PantsForBirds/adsbee/docs/adsbee-1090/index.md

# ADSBee 1090 Family

Receivers in the ADSBee 1090 family are built around a discrete Mode S receiver architecture with a custom RP2040 PIO-based decoder. These devices offer full-featured ground station level performance comparable to SDR-based receivers for a fraction of the power and size.

All receivers currently offered in the ADSBee 1090 family are capable of dual band reception (Mode S + UAT, including traffic and weather), and many offer network capabilities (WiFi or Ethernet).

To get an ADSBee 1090 up and running, see the [Quick Start](../getting-started/quick-start.md).

## 1090U

Dual-band Mode S and UAT receiver with USB, UART, and WiFi connectivity options.

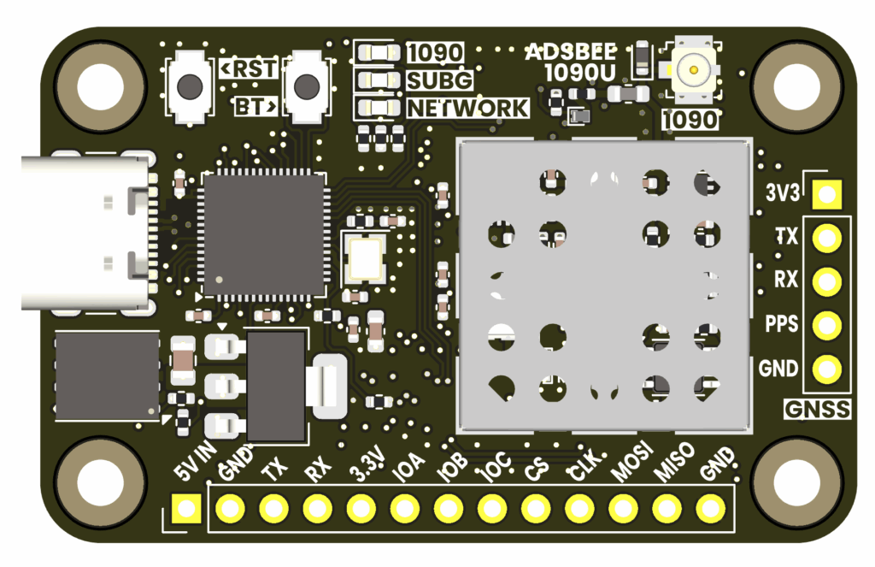
[picture p9: docs/assets/adsbee-1090/2025-06-image-1024x663.png]
ADSBee 1090U


## m1090

Single-band solder-down receiver module for OEM applications.

Dual band RX / WiFi / Ethernet functionality available with additional components.

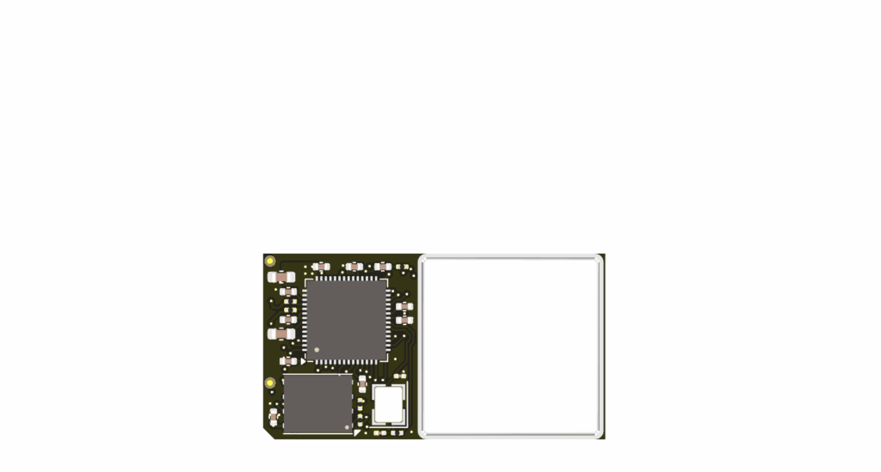
[picture p10: docs/assets/adsbee-1090/2025-06-image-2-e1749438381519-1024x549.png]
ADSBee m1090


## Winglet

Tri-band Mode S, UAT, and 2.4GHz Remote ID receiver with USB, UART, WiFi, built-in battery, illuminated ePaper screen, membrane keypad, and sensors for electronic flight bag and high performance ground station applications. See the [ADSBee Winglet page](winglet.md).

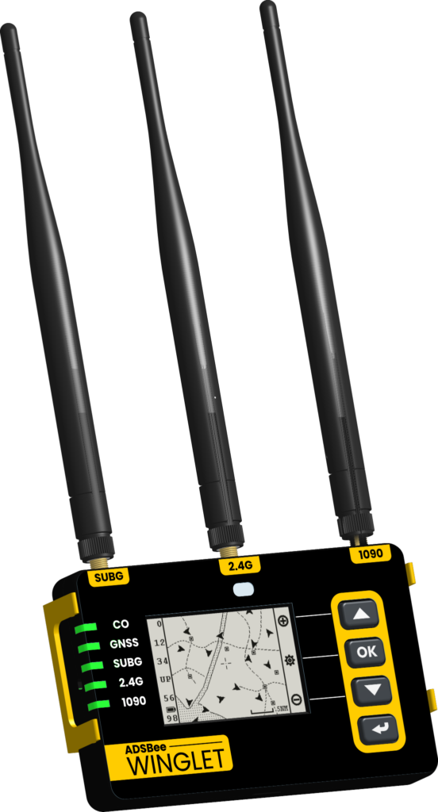
[picture p11: docs/assets/adsbee-1090/2026-07-adsbee-winglet-angle-right-552x1024.png]
ADSBee Winglet


## GS3M PoE

Dual-band Mode S and UAT industrial ground station with PoE.

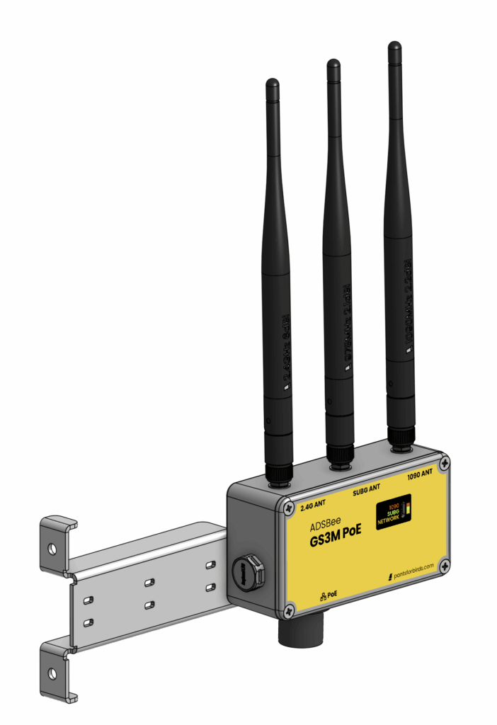
[picture p12: docs/assets/adsbee-1090/2025-09-adsbee-gs3m-poe-pic-702x1024.png]
ADSBee GS3M PoE


## Datasheet

Datasheets are available on GitHub:

- [ADSBee 1090 datasheet](https://github.com/PantsForBirds/adsbee/blob/main/word/exports/datasheet_adsbee_1090.pdf)
- [ADSBee 1090 firmware reference guide](https://github.com/PantsForBirds/adsbee/blob/main/word/exports/firmware_reference_guide_adsbee_1090.pdf)
- [ADSBee m1090 eval board datasheet](https://github.com/PantsForBirds/adsbee/blob/main/word/exports/datasheet_adsbee_m1090_eval_board.pdf)
- [ADSBee GS3M PoE datasheet](https://github.com/PantsForBirds/adsbee/blob/main/word/exports/datasheet_gs3m_poe.pdf)

## Software

- [ADSBee 1090 web console](https://github.com/PantsForBirds/adsbee/blob/main/software/adsbee_1090_console/README.md)
- [Building the firmware](https://github.com/PantsForBirds/adsbee/blob/main/firmware/README.md)
