PantsForBirds/adsbee/docs/community.md

# Community

- [Quick start documentation](getting-started/quick-start.md)
- [Join us on Discord!](https://discord.gg/KRgVT9sSVW)
- [Subscribe to the mailing list](https://groups.google.com/a/pantsforbirds.com/g/adsbee-newsletter)
- [View code on GitHub](https://github.com/PantsForBirds/adsbee)

## Gallery

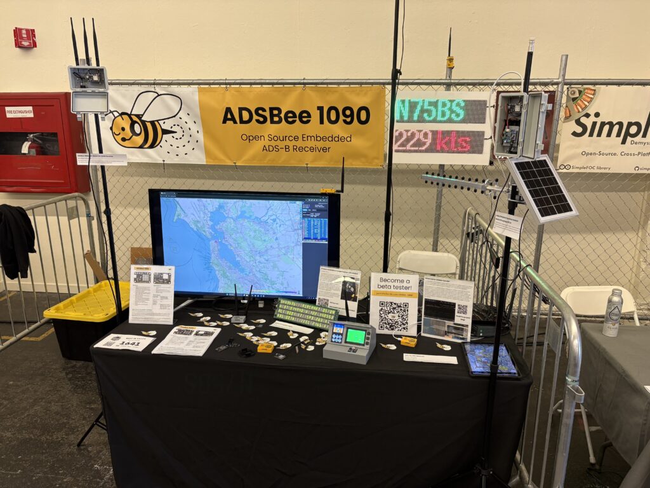
[picture p14: docs/assets/community/2025-07-img-0150-1-1024x768.jpg]
Our table at Open Sauce!


*Our table at Open Sauce!*

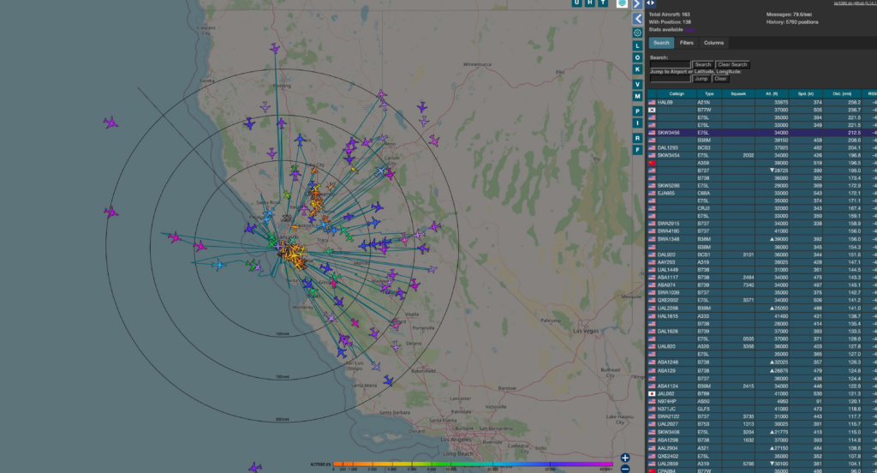
[picture p15: docs/assets/community/2025-03-image-5-1024x552.png]
ADSBee community project


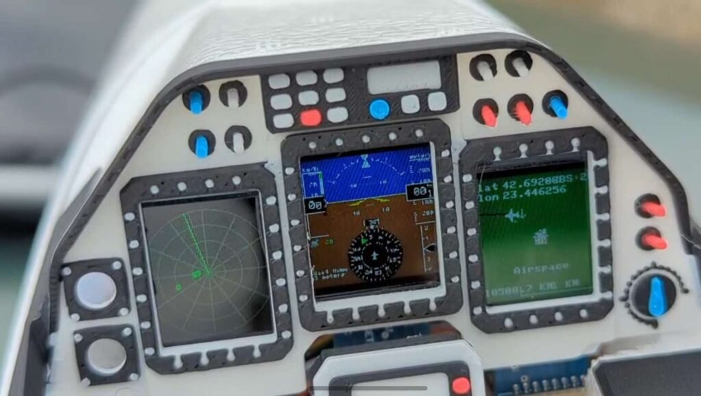
[picture p16: docs/assets/community/2025-10-adsbee-martinov-1024x578.jpg]
ADSBee community project


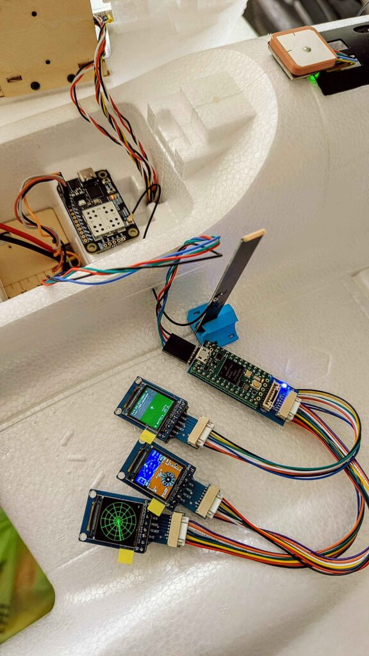
[picture p17: docs/assets/community/2025-10-adsbee-martinov-parts-576x1024.jpg]
ADSBee community project


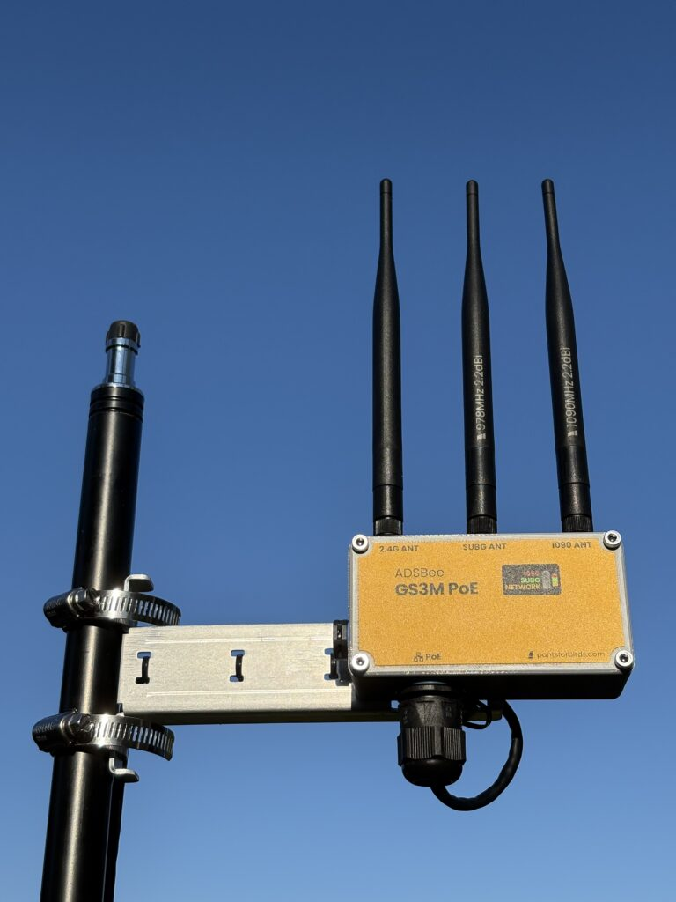
[picture p18: docs/assets/community/2025-09-img-0252-1-768x1024.jpg]
ADSBee community project


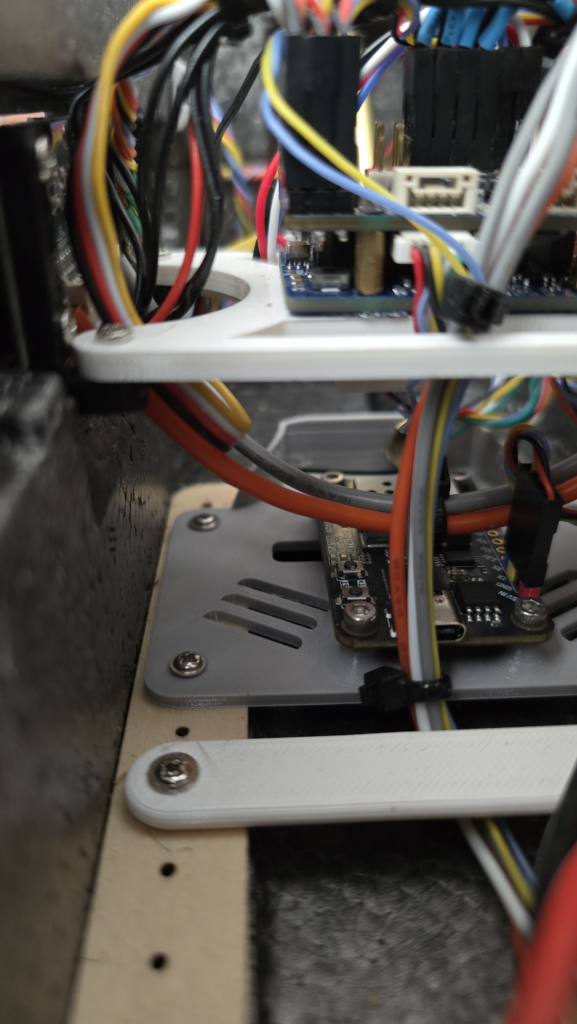
[picture p19: docs/assets/community/2025-03-image-3-577x1024.png]
ADSBee community project


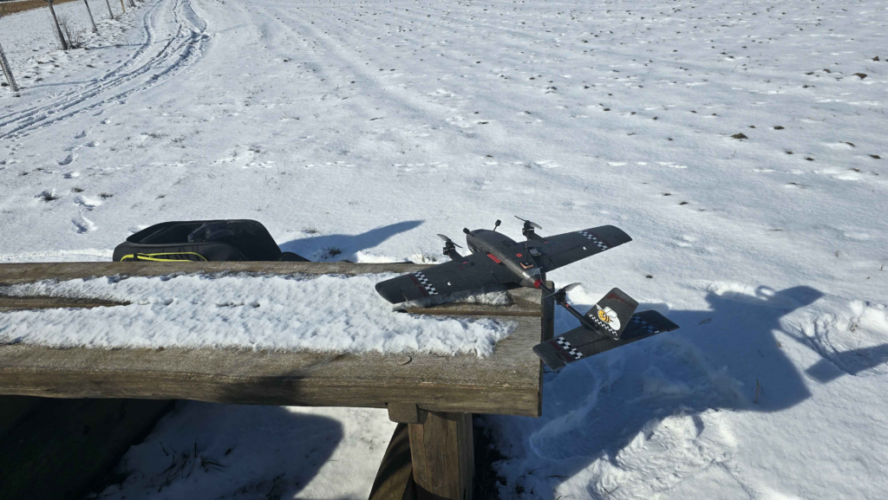
[picture p20: docs/assets/community/2025-03-image-2-1024x577.png]
ADSBee community project


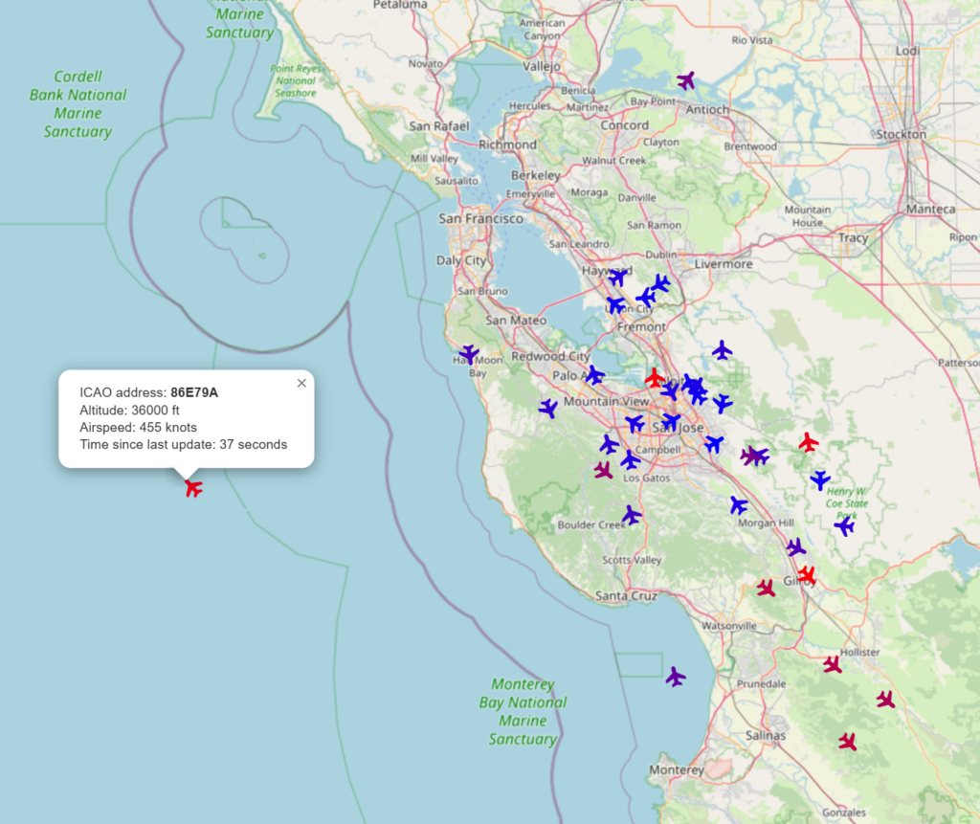
[picture p21: docs/assets/community/2025-03-image-1024x861.png]
ADSBee community project


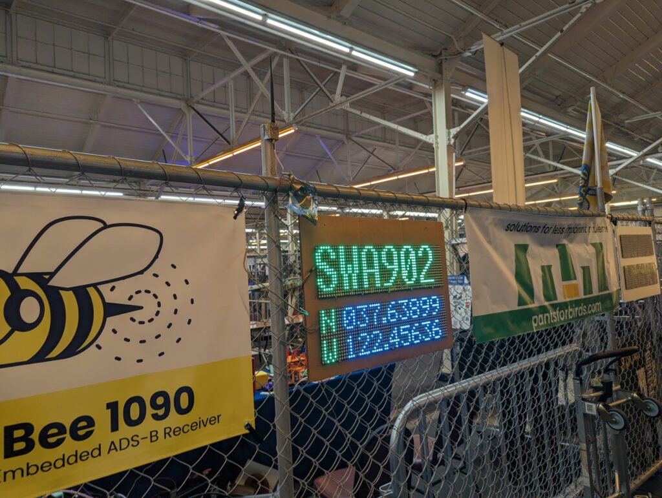
[picture p22: docs/assets/community/2024-06-led-display-coords-1024x771.jpg]
ADSBee community project


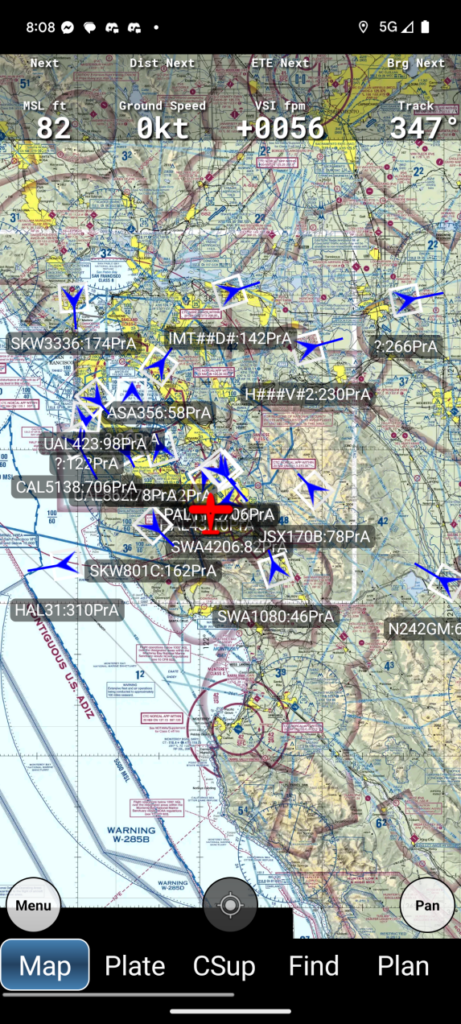
[picture p23: docs/assets/community/2024-10-image-3-461x1024.png]
ADSBee community project


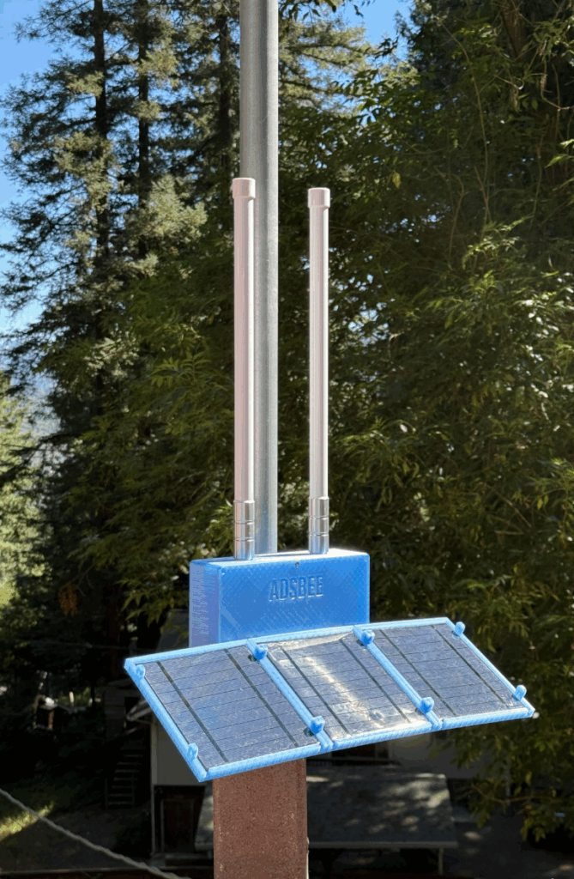
[picture p24: docs/assets/community/2025-10-adsbee-solar-ext-669x1024.png]
ADSBee community project


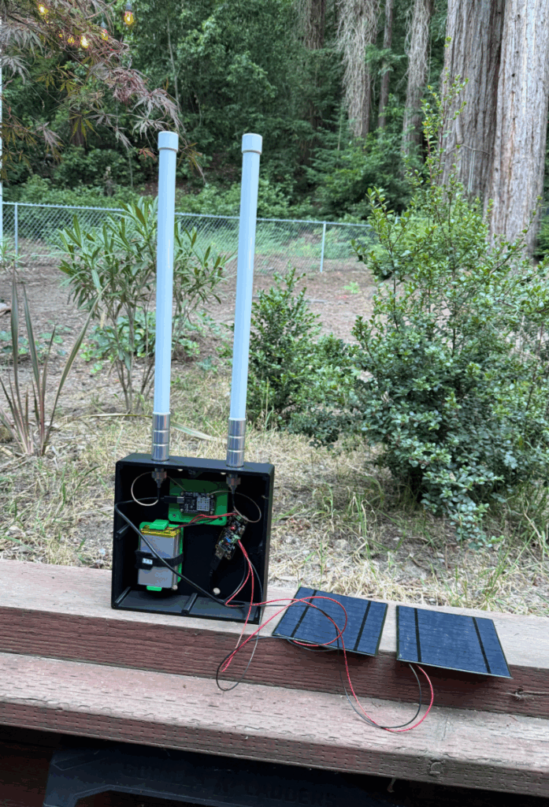
[picture p25: docs/assets/community/2025-10-adsbee-solar-open-697x1024.png]
ADSBee community project


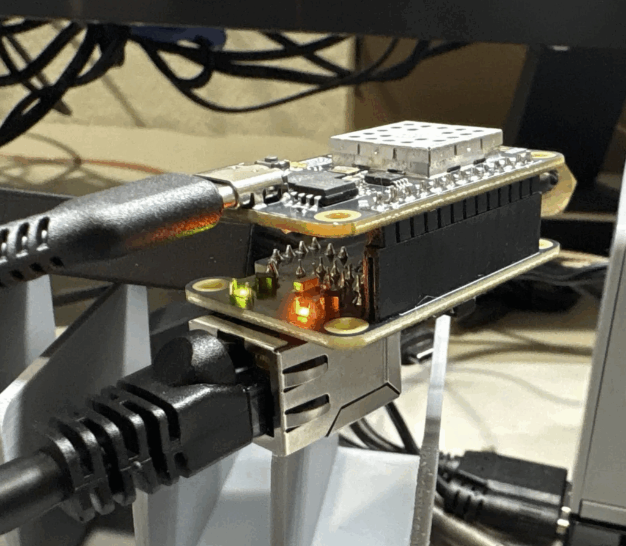
[picture p26: docs/assets/community/2025-07-image-1-1024x893.png]
ADSBee community project


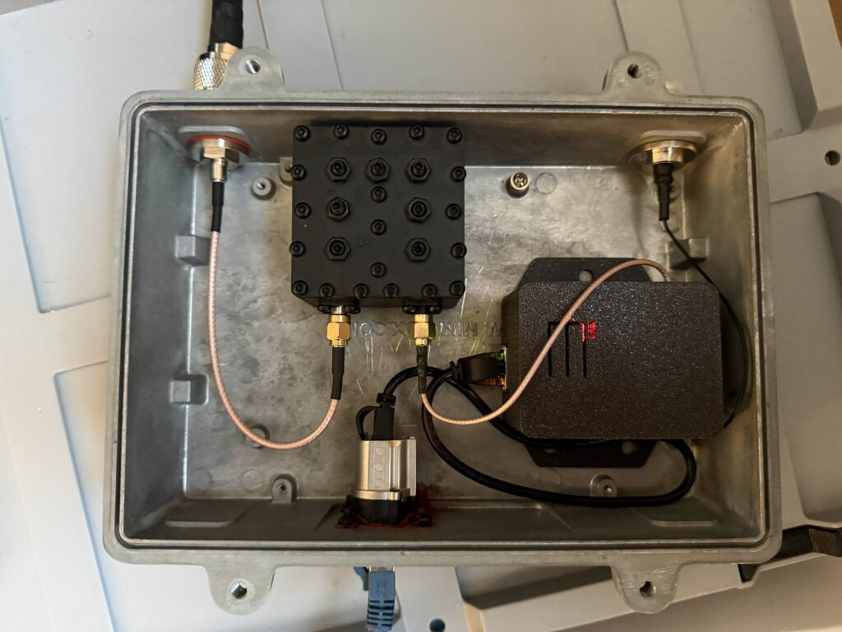
[picture p27: docs/assets/community/2025-10-adsbee-vifino-1024x768.jpg]
ADSBee community project


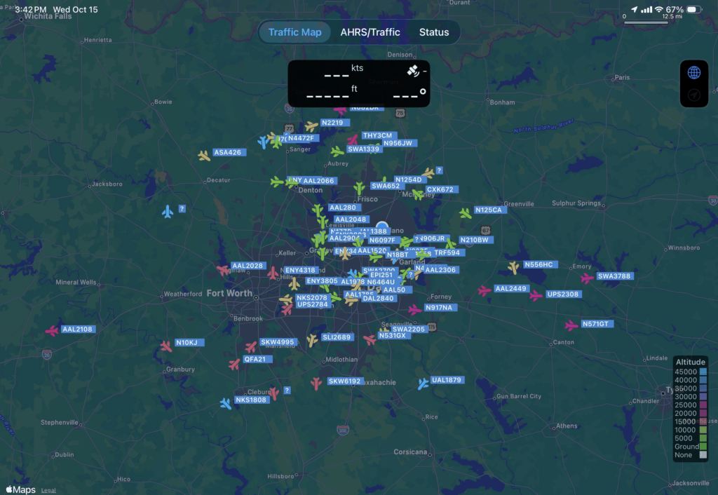
[picture p28: docs/assets/community/2025-10-adsbee-bulb-1024x706.png]
ADSBee community project
