PantsForBirds/adsbee/firmware/adsbee_1090/pico/application/peripherals/cc1312/cc1312.cc

#include "cc1312.hh"

// Get access to raw application binary for flashing.
#include "adsbee.hh"  // Get access to subg radio for calling higher level interaction functions.
#include "bin/binaries.c"
#include "cpu_utils.hh"
#include "crc.hh"  // For IEEE 802.3 CRC32 calculation.
#include "hal.hh"

const CC1312::SPIPeripheralConfig kDefaultSPIPeripheralConfig;  // use defaults
const CC1312::SPIPeripheralConfig kBootloaderSPIPeripheralConfig = {
    .bits_per_transfer = 8,
    .cpol = SPI_CPOL_1,
    .cpha = SPI_CPHA_1,
    .order = SPI_MSB_FIRST,
};

bool CC1312::Init(bool spi_already_initialized) {
    // CC1312 enable pin.
    gpio_init(config_.enable_pin);
    SetEnableState(SettingsManager::kEnableStateEnabled);  // Enable the CC1312.
    uint32_t enable_timestamp_ms = get_time_since_boot_ms();

    // CC1312 chip select pin.
    gpio_init(config_.spi_cs_pin);
    gpio_set_dir(config_.spi_cs_pin, GPIO_OUT);
    gpio_put(config_.spi_cs_pin, 1);  // Deselect the CC1312.
    // CC1312 IRQ pin.
    gpio_init(config_.irq_pin);
    gpio_set_dir(config_.irq_pin, GPIO_IN);
    gpio_set_pulls(config_.irq_pin, true, false);  // IRQ pin is pulled up.

    if (!spi_already_initialized) {
        // CC1312 SPI pins.
        gpio_set_function(config_.spi_clk_pin, GPIO_FUNC_SPI);
        gpio_set_function(config_.spi_mosi_pin, GPIO_FUNC_SPI);
        gpio_set_function(config_.spi_miso_pin, GPIO_FUNC_SPI);
        gpio_set_drive_strength(config_.spi_clk_pin, config_.spi_drive_strength);
        gpio_set_drive_strength(config_.spi_mosi_pin, config_.spi_drive_strength);
        gpio_set_drive_strength(config_.spi_cs_pin, config_.spi_drive_strength);
        gpio_set_pulls(config_.spi_clk_pin, config_.spi_pullup, config_.spi_pulldown);   // Clock pin pulls.
        gpio_set_pulls(config_.spi_mosi_pin, config_.spi_pullup, config_.spi_pulldown);  // MOSI pin pulls.
        gpio_set_pulls(config_.spi_cs_pin, config_.spi_pullup, config_.spi_pulldown);    // CS pin pulls.
        gpio_set_pulls(config_.spi_miso_pin, config_.spi_pullup, config_.spi_pulldown);  // MISO pin pulls.

        // Initialize SPI Peripheral.
        spi_init(config_.spi_handle, config_.spi_clk_freq_hz);
        spi_set_format(config_.spi_handle,
                       8,           // Bits per transfer.
                       SPI_CPOL_0,  // Polarity (CPOL).
                       SPI_CPHA_0,  // Phase (CPHA).
                       SPI_MSB_FIRST);
        active_clk_config_ = spi_get_clk();
        // Nobody else is on the bus yet, so we don't have to worry about restoring the standby clock config.
    } else {
        // SPI peripheral was already initialized. Make sure to not stomp on it when setting a clock rate.
        standby_clk_config_ = spi_get_clk();
        spi_set_baudrate(config_.spi_handle, config_.spi_clk_freq_hz);
        active_clk_config_ = spi_get_clk();
        spi_set_clk(standby_clk_config_);
    }

    while (get_time_since_boot_ms() - enable_timestamp_ms < kBootupDelayMs) {
    }

    CONSOLE_INFO("CC1312::Init", "Initializing CC1312. Entering bootloader mode to check firmware contents.");
    if (!EnterBootloader()) {
        CONSOLE_ERROR("CC1312::Init", "Failed to enter bootloader mode.");
        return false;
    }
    if (!ApplicationIsUpToDate()) {
        CONSOLE_INFO("CC1312::Init", "Application is not up to date. Attempting to flash application binary.");
        if (!Flash()) {
            CONSOLE_ERROR("CC1312::Init", "Failed to flash application binary.");
            return false;
        }
        CONSOLE_INFO("CC1312::Init", "Application binary flashed successfully.");
        // Flash automatically exits bootloader mode.
    } else {
        CONSOLE_INFO("CC1312::Init", "Application is up to date. No need to flash.");
        if (!ExitBootloader()) {
            CONSOLE_ERROR("CC1312::Init", "Failed to exit bootloader mode.");
            return false;
        }
    }

    // The CC1312 application serves SPI ~0.5 s after reset (it blinks its LED first). Probe quietly until it answers
    // so the boot doesn't produce a burst of failed status reads.
    uint32_t bootup_comms_wait_begin_timestamp_ms = get_time_since_boot_ms();
    bool application_ready = false;
    while (get_time_since_boot_ms() - bootup_comms_wait_begin_timestamp_ms < kBootupMaxCommsWaitIntervalMs) {
        if (ProbeApplication()) {
            application_ready = true;
            break;
        }
        sleep_ms(kBootupProbeIntervalMs);
    }
    if (!application_ready) {
        CONSOLE_ERROR("CC1312::Init", "CC1312 application did not respond within %u ms after boot.",
                      kBootupMaxCommsWaitIntervalMs);
        return false;
    }
    if (!Update()) {
        CONSOLE_ERROR("CC1312::Init", "Failed to read CC1312 status after boot.");
        return false;
    }
    CONSOLE_INFO("CC1312::Init", "CC1312 application ready %u ms after boot.",
                 get_time_since_boot_ms() - bootup_comms_wait_begin_timestamp_ms);

    CONSOLE_INFO("CC1312::Init", "CC1312 initialized successfully.");

    return true;
}

bool CC1312::Update() {
    last_poll_timestamp_ms_ = get_time_since_boot_ms();
    more_raw_packets_pending_ = false;
    raw_packets_arriving_ = false;
    // Report a lost link once; reads fail fast and quietly while it stays down (see SPILinkGate).
    bool link_was_down = adsbee.subg_radio.IsLinkDown();
    // Query CC1312's device status.
    if (adsbee.subg_radio.Read(ObjectDictionary::Address::kAddrDeviceStatus, device_status)) {
        // We only update the device_status vars exposed publicly here. Other reads of device_status are for
        // internal use only.
        num_queued_log_messages = device_status.num_queued_log_messages;
        queued_log_messages_packed_size_bytes = device_status.queued_log_messages_packed_size_bytes;
        num_queued_sc_command_requests = device_status.num_queued_sc_command_requests;

        // Record number of attempted and successful message decodes from the Sub-GHz radio since the last update.
        adsbee.aircraft_dictionary.RecordSubGHzMetrics(
            device_status.num_raw_uat_adsb_packets, device_status.num_valid_uat_adsb_packets,
            device_status.num_raw_uat_uplink_packets, device_status.num_valid_uat_uplink_packets);

        adsbee.sync_pulse_service.ReportFlags(SyncPulseService::kSubscriberCC1312, device_status.mlat_sync_flags);
        if (!in_bootloader_ && IsEnabled()) {
            adsbee.sync_pulse_service.Allow();  // The application just answered a status read.
        }
        // A new sync pulse's count, once, in one small un-acked write: there is no RP2040 -> CC1312 status write to
        // carry it. A lost write only costs this sync point.
        ObjectDictionary::SyncPulse pulse;
        if (adsbee.sync_pulse_service.TakeNewPulse(pulse)) {
            adsbee.subg_radio.Write(ObjectDictionary::Address::kAddrSyncPulse, pulse);
        }

        // Nothing queued: skip the packet array read, so an idle poll is one status read (as on the ESP32).
        more_raw_packets_pending_ = CompositeArray::RawPackets::MorePending(device_status.pending_raw_packets_len_bytes);
        raw_packets_arriving_ =
            device_status.pending_raw_packets_len_bytes > sizeof(CompositeArray::RawPackets::Header);
        if (raw_packets_arriving_) {
            // Read one array of packets from the queues. The CC1312 fills it with as many packets as fit.
            uint8_t read_buf[CompositeArray::RawPackets::kMaxLenBytes] = {0};
            if (!adsbee.subg_radio.Read(
                    ObjectDictionary::Address::kAddrCompositeArrayRawPackets, read_buf,
                    CompositeArray::RawPackets::ReadLenBytes(device_status.pending_raw_packets_len_bytes))) {
                more_raw_packets_pending_ = false;
                raw_packets_arriving_ = false;
                CONSOLE_ERROR("CC1312::Update", "Unable to read CC1312 raw packet array.");
                return false;
            }
            if (!CompositeArray::UnpackRawPacketsBufferToQueues(read_buf, sizeof(read_buf), nullptr,
                                                                &adsbee.raw_uat_adsb_packet_queue,
                                                                &adsbee.raw_uat_uplink_packet_queue)) {
                CONSOLE_ERROR("CC1312::Update", "Failed to unpack raw packets from CC1312.");
                return false;
            }
        }

    } else {
        BlockSyncPulses();  // The CC1312 may be resetting.
        if (!link_was_down) CONSOLE_ERROR("CC1312::Update", "Unable to read CC1312 status.");
        return false;
    }

    last_update_timestamp_ms_ = get_time_since_boot_ms();
    return true;
}

void CC1312::BlockSyncPulses() {
    adsbee.sync_pulse_service.Block();
    adsbee.sync_pulse_service.ReportAbsent(SyncPulseService::kSubscriberCC1312);
}

void CC1312::AllowSyncPulsesInReset() {
    if (enabled_ == SettingsManager::EnableState::kEnableStateDisabled) {
        adsbee.sync_pulse_service.Allow();
    }
}

bool CC1312::ApplicationIsUpToDate() {
    // Verify application binary.
    uint32_t table_crc = crc32_ieee_802_3(sub_ghz_radio_bin, sub_ghz_radio_bin_size);
    uint32_t device_crc = 0;
    if (!BootloaderCommandCRC32(device_crc, kBaseAddrFlashMem, sub_ghz_radio_bin_size)) {
        CONSOLE_ERROR("CC1312::ApplicationIsUpToDate", "Failed to calculate CRC32 of the application binary.");
        return false;
    }
    // Keep what the CC1312's flash holds for AT+CONFIG_HASH.
    flash_crcs_valid_ = false;
    uint32_t ccfg_crc = 0;
    if (BootloaderCommandCRC32(ccfg_crc, kFlashAddrCCFG, kCCFGLenBytes)) {
        application_crc_ = device_crc;
        ccfg_crc_ = ccfg_crc;
        flash_crcs_valid_ = true;
    } else {
        CONSOLE_WARNING("CC1312::ApplicationIsUpToDate", "Failed to calculate CRC32 of the CCFG.");
    }
    if (table_crc != device_crc) {
        CONSOLE_ERROR("CC1312::ApplicationIsUpToDate",
                      "CRC32 mismatch after flashing application binary. Expected 0x%x, got 0x%x.", table_crc,
                      device_crc);
        return false;
    }
    CONSOLE_PRINTF("CC1312::ApplicationIsUpToDate: Application binary flashed successfully, CRC32 matches: 0x%x.\r\n",
                   table_crc);
    return true;
}

bool CC1312::ProbeApplication() {
    static SPICoprocessorPacket::SCReadRequestPacket request_packet;
    static SPICoprocessorPacket::SCResponsePacket response_packet;
    const uint16_t len = sizeof(ObjectDictionary::SubGHzDeviceStatus);
    request_packet.cmd = ObjectDictionary::SCCommand::kCmdReadFromSlave;
    request_packet.addr = ObjectDictionary::Address::kAddrDeviceStatus;
    request_packet.offset = 0;
    request_packet.len = len;
    request_packet.PopulateCRC();
    if (SPIWriteBlocking(request_packet.GetBuf(), request_packet.GetBufLenBytes()) < 0) return false;
    if (!SPIWaitForHandshake()) return false;  // Application not serving SPI yet.
    response_packet.data_len_bytes = len;
    if (SPIReadBlocking(response_packet.GetBuf(),
                        SPICoprocessorPacket::SCResponsePacket::GetBufLenForPayloadLenBytes(len)) < 0) {
        return false;
    }
    return response_packet.IsValid() && response_packet.cmd == ObjectDictionary::SCCommand::kCmdDataBlock &&
           response_packet.data_len_bytes == len;
}

bool CC1312::BootloaderCommandBankErase() {
    uint8_t cmd_buf[1] = {kCmdBankErase};
    if (!BootloaderSendBufferCheckSuccess(cmd_buf, sizeof(cmd_buf))) {
        CONSOLE_ERROR("CC1312::BootloaderCommandBankErase", "Failed to send bank erase command.");
        return false;
    }
    return true;
}

bool CC1312::BootloaderCommandCRC32(uint32_t& crc, uint32_t address, uint32_t num_bytes, uint32_t read_repeat_count) {
    uint8_t cmd_buf[13] = {kCmdCRC32,
                           static_cast<uint8_t>((address >> 24) & 0xFFu),
                           static_cast<uint8_t>((address >> 16) & 0xFFu),
                           static_cast<uint8_t>((address >> 8) & 0xFFu),
                           static_cast<uint8_t>(address & 0xFFu),
                           static_cast<uint8_t>((num_bytes >> 24) & 0xFFu),
                           static_cast<uint8_t>((num_bytes >> 16) & 0xFFu),
                           static_cast<uint8_t>((num_bytes >> 8) & 0xFFu),
                           static_cast<uint8_t>(num_bytes & 0xFFu),
                           static_cast<uint8_t>((read_repeat_count >> 24) & 0xFFu),
                           static_cast<uint8_t>((read_repeat_count >> 16) & 0xFFu),
                           static_cast<uint8_t>((read_repeat_count >> 8) & 0xFFu),
                           static_cast<uint8_t>(read_repeat_count & 0xFFu)};
    if (!BootloaderSendBuffer(cmd_buf, sizeof(cmd_buf))) {
        CONSOLE_ERROR("CC1312::BootloaderCommandCRC32", "Failed to send CRC32 command.");
        return false;
    }
    uint8_t crc_buf[4] = {0};
    if (!BootloaderReceiveBuffer(crc_buf, sizeof(crc_buf))) {
        CONSOLE_ERROR("CC1312::BootloaderCommandCRC32", "Failed to receive CRC32 result.");
        return false;
    }
    crc = (static_cast<uint32_t>(crc_buf[0]) << 24) | (static_cast<uint32_t>(crc_buf[1]) << 16) |
          (static_cast<uint32_t>(crc_buf[2]) << 8) | static_cast<uint32_t>(crc_buf[3]);
    return true;
}

bool CC1312::BootloaderCommandDownload(uint32_t address, uint32_t num_bytes) {
    uint8_t cmd_buf[9]{kCmdDownload,
                       static_cast<uint8_t>((address >> 24) & 0xFFu),
                       static_cast<uint8_t>((address >> 16) & 0xFFu),
                       static_cast<uint8_t>((address >> 8) & 0xFFu),
                       static_cast<uint8_t>(address & 0xFFu),
                       static_cast<uint8_t>((num_bytes >> 24) & 0xFFu),
                       static_cast<uint8_t>((num_bytes >> 16) & 0xFFu),
                       static_cast<uint8_t>((num_bytes >> 8) & 0xFFu),
                       static_cast<uint8_t>(num_bytes & 0xFFu)};
    if (!BootloaderSendBufferCheckSuccess(cmd_buf, sizeof(cmd_buf))) {
        CONSOLE_ERROR("CC1312::BootloaderCommandDownload",
                      "Failed to send download command. Firmware size or address might be invalid, or something else "
                      "went wrong.");
        return false;
    }
    return true;
}

CC1312::CommandReturnStatus CC1312::BootloaderCommandGetStatus() {
    uint8_t cmd_buf[1] = {kCmdGetStatus};
    if (!BootloaderSendBuffer(cmd_buf, sizeof(cmd_buf))) {
        CONSOLE_ERROR("CC1312::BootloaderCommandGetStatus", "Failed to send command.");
        return kCmdRetDriverError;
    }
    uint8_t status_buf[1] = {0};
    if (!BootloaderReceiveBuffer(status_buf, sizeof(status_buf))) {
        CONSOLE_ERROR("CC1312::BootloaderCommandGetStatus", "Failed to receive command status.");
        return kCmdRetDriverError;
    }
    CommandReturnStatus return_status = static_cast<CommandReturnStatus>(status_buf[0]);
    if (return_status != kCmdRetSuccess) {
        CONSOLE_ERROR("CC1312::BootloaderCommandGetStatus", "Command failed with status 0x%x. (%s).", return_status,
                      CommandReturnStatusToString(return_status));
        return return_status;
    }

    return return_status;
}

bool CC1312::BootloaderCommandPing() {
    uint8_t cmd_buf[1] = {kCmdPing};
    bool ping_acked = BootloaderSendBufferCheckSuccess(cmd_buf, sizeof(cmd_buf));
    if (!ping_acked) {
        CONSOLE_ERROR("CC1312::BootloaderCommandPing", "Ping command failed.");
        return false;
    }
    return true;
}

bool CC1312::BootloaderCommandReset() {
    uint8_t cmd_buf[1] = {kCmdReset};
    bool reset_acked = BootloaderSendBuffer(cmd_buf, sizeof(cmd_buf));
    if (!reset_acked) {
        CONSOLE_ERROR("CC1312::BootloaderCommandReset", "Reset command failed.");
        return false;
    }
    return true;
}

bool CC1312::BootloaderCommandSendData(const uint8_t* data, uint32_t data_len) {
    static const uint32_t kMaxDataLength = 255 - 3;  // Max packet length minus command, size, checksum Bytes.
    if (data_len > kMaxDataLength) {
        CONSOLE_ERROR("CC1312::BootloaderCommandSendData", "Data length %d exceeds maximum allowed length of %d bytes.",
                      data_len, kMaxDataLength);
        return false;
    }
    uint8_t cmd_buf[1 + data_len] = {0x0};
    cmd_buf[0] = kCmdSendData;
    memcpy(cmd_buf + 1, data, data_len);  // Copy the data to the command buffer.
    if (!BootloaderSendBufferCheckSuccess(cmd_buf, sizeof(cmd_buf))) {
        CONSOLE_ERROR("CC1312::BootloaderCommandSendData", "Programming failed.");
        return false;
    }
    return true;
}

bool CC1312::BootloaderCommandSetCCFG(BootloaderCCFGFieldID field_id, uint32_t value) {
    uint8_t cmd_buf[9] = {kCmdSetCCFG,
                          static_cast<uint8_t>((field_id >> 24) & 0xFFu),
                          static_cast<uint8_t>((field_id >> 16) & 0xFFu),
                          static_cast<uint8_t>((field_id >> 8) & 0xFFu),
                          static_cast<uint8_t>(field_id & 0xFFu),
                          static_cast<uint8_t>((value >> 24) & 0xFFu),
                          static_cast<uint8_t>((value >> 16) & 0xFFu),
                          static_cast<uint8_t>((value >> 8) & 0xFFu),
                          static_cast<uint8_t>(value & 0xFFu)};

    if (!BootloaderSendBufferCheckSuccess(cmd_buf, sizeof(cmd_buf))) {
        CONSOLE_ERROR("CC1312::BootloaderCommandSetCCFG", "Failed to send CCFG set command.");
        return false;
    }
    return true;
}

bool CC1312::BootloaderReadCCFGConfig(BootloaderCCFGConfig& ccfg_config) {
    uint32_t bl_config = 0;

    if (!BootloaderCommandMemoryRead(kBaseAddrCCFG + kCCFGRegOffBLConfig, &bl_config, 1)) {
        CONSOLE_ERROR("CC1312::BootloaderReadCCFGConfig", "Failed to read CCFG configuration.");
        return false;
    }

    ccfg_config.bl_enabled = ((bl_config >> 24) & 0xFF) == 0xC5;
    ccfg_config.bl_backdoor_level = (bl_config >> 16) & 0x01;       // Bit[16] is the backdoor level.
    ccfg_config.bl_backdoor_pin = (bl_config >> 8) & 0xFF;          // Bits[15:8] are the backdoor pin.
    ccfg_config.bl_backdoor_enabled = (bl_config & 0x0FF) == 0xC5;  // Bits[7:0] are the backdoor enabled flag.

    uint32_t erase_conf = 0;
    if (!BootloaderCommandMemoryRead(kBaseAddrCCFG + kCCFGRegOffEraseConf, &erase_conf, 1)) {
        CONSOLE_ERROR("CC1312::BootloaderReadCCFGConfig", "Failed to read CCFG erase configuration.");
        return false;
    }

    ccfg_config.chip_erase_disabled = ((erase_conf >> 8) & 0b1) == 0;  // Bit[8] is the chip erase disabled flag.
    ccfg_config.bank_erase_disabled = (erase_conf & 0b1) == 0;         // Bit[0] is the bank erase disabled flag.

    return true;
}

bool CC1312::BootloaderWriteCCFGConfig(const BootloaderCCFGConfig& ccfg_config) {
    if (!BootloaderCommandSetCCFG(kCCFGFieldIDIDBankEraseDis, ccfg_config.bank_erase_disabled ? 0 : 1)) {
        CONSOLE_ERROR("CC1312::BootloaderWriteCCFGConfig", "Failed to set bank erase disabled CCFG field.");
        return false;
    }
    if (!BootloaderCommandSetCCFG(kCCFGFieldIDChipEraseDis, ccfg_config.chip_erase_disabled ? 0 : 1)) {
        CONSOLE_ERROR("CC1312::BootloaderWriteCCFGConfig", "Failed to set chip erase disabled CCFG field.");
        return false;
    }
    if (!BootloaderCommandSetCCFG(kCCFGFieldIDBLBackdoorEn, ccfg_config.bl_backdoor_enabled ? 0xC5 : 0xFF)) {
        CONSOLE_ERROR("CC1312::BootloaderWriteCCFGConfig", "Failed to set bootloader backdoor enabled CCFG field.");
        return false;
    }
    if (!BootloaderCommandSetCCFG(kCCFGFieldIDBLBackdoorPin, ccfg_config.bl_backdoor_pin)) {
        CONSOLE_ERROR("CC1312::BootloaderWriteCCFGConfig", "Failed to set bootloader backdoor pin CCFG field.");
        return false;
    }
    if (!BootloaderCommandSetCCFG(kCCFGFieldIDBackdoorLevel, ccfg_config.bl_backdoor_level ? 1 : 0)) {
        CONSOLE_ERROR("CC1312::BootloaderWriteCCFGConfig", "Failed to set bootloader backdoor level CCFG field.");
        return false;
    }
    if (!BootloaderCommandSetCCFG(kCCFGFieldIDBLEnable, ccfg_config.bl_enabled ? 0xC5 : 0xFF)) {
        CONSOLE_ERROR("CC1312::BootloaderWriteCCFGConfig", "Failed to set bootloader enabled CCFG field.");
        return false;
    }

    return true;
}

bool CC1312::EnterBootloader() {
    SetEnableState(SettingsManager::kEnableStateDisabled);
    gpio_put(config_.sync_pin, 1);
    SetEnableState(SettingsManager::kEnableStateEnabled);
    in_bootloader_ = true;

    // Bootlaoder is active, override CPHA and CPOL.
    // WARNING: Other devices on the bus can't be used while CC1312 is in bootloader mode.
    // spi_set_format(config_.spi_handle, kBootloaderSPIPeripheralConfig.bits_per_transfer,
    //                kBootloaderSPIPeripheralConfig.cpol, kBootloaderSPIPeripheralConfig.cpha,
    //                kBootloaderSPIPeripheralConfig.order);

    return BootloaderCommandPing();
}

bool CC1312::ExitBootloader() {
    in_bootloader_ = false;
    SetEnableState(SettingsManager::kEnableStateDisabled);
    gpio_put(config_.sync_pin, 0);
    SetEnableState(SettingsManager::kEnableStateEnabled);

    // spi_set_format(config_.spi_handle, kDefaultSPIPeripheralConfig.bits_per_transfer,
    // kDefaultSPIPeripheralConfig.cpol,
    //                kDefaultSPIPeripheralConfig.cpha, kDefaultSPIPeripheralConfig.order);

    return true;
}

bool CC1312::BootloaderReceiveBuffer(uint8_t* buf, uint16_t buf_len_bytes) {
    uint8_t rx_buf[buf_len_bytes + 2] = {0};  // Includes size Byte and checksum Byte.
    uint32_t start_time_ms = get_time_since_boot_ms();
    bool received_response = false;
    while (!received_response) {
        if (get_time_since_boot_ms() - start_time_ms > kSPITransactionTimeoutMs) {
            SPIEndTransaction();  // End transaction after error.
            CONSOLE_ERROR("CC1312::BootloaderReceiveBuffer", "Timed out waiting for response from CC1312.");
            return false;
        }

        // Read the first byte of the response.
        int16_t bytes_read = SPIReadBlocking(rx_buf, 1, false);
        if (bytes_read < 0) {
            SPIEndTransaction();  // End transaction after error.
            CONSOLE_ERROR("CC1312::BootloaderReceiveBuffer",
                          "Failed to read response, SPI write read call returned error code 0x%x.", bytes_read);
            return false;
        } else if (bytes_read != 1) {
            SPIEndTransaction();  // End transaction after error.
            CONSOLE_ERROR("CC1312::BootloaderReceiveBuffer",
                          "Failed to read first Byte of response, expected %d Bytes but read %d.", 1, bytes_read);
            return false;
        } else if (rx_buf[0] != 0) {
            received_response = true;
        }
    }

    uint16_t rx_len_bytes = rx_buf[0];

    // Guard against a garbage length byte overflowing rx_buf or the output buffer. A valid frame is at minimum 2 Bytes
    // (size Byte + checksum Byte), with 0 payload allowed; a length of 1 would underflow the rx_len_bytes - 2 math
    // below.
    if (rx_len_bytes < 2 || rx_len_bytes > static_cast<uint16_t>(buf_len_bytes) + 2) {
        SPIEndTransaction();
        CONSOLE_ERROR("CC1312::BootloaderReceiveBuffer", "Received invalid length byte 0x%x (expected 2 to %d).",
                      rx_len_bytes, buf_len_bytes + 2);
        return false;
    }

    uint8_t calculated_checksum = 0;

    int16_t bytes_read =
        SPIReadBlocking(rx_buf + 1, rx_len_bytes - 1, false);  // End transaction after reading the buffer.
    bool read_success = true;
    if (bytes_read < 0) {
        CONSOLE_ERROR("CC1312::BootloaderReceiveBuffer",
                      "Failed to read response, SPI write read call returned error code 0x%x.", bytes_read);
        read_success = false;
    } else if (bytes_read != rx_len_bytes - 1) {
        CONSOLE_ERROR("CC1312::BootloaderReceiveBuffer", "Failed to read response, expected %d Bytes but read %d.",
                      rx_len_bytes - 1, bytes_read);
        read_success = false;
    } else {
        // Verify received checksum.
        uint16_t received_checksum = rx_buf[1];
        for (uint16_t i = 2; i < rx_len_bytes; i++) {
            calculated_checksum += rx_buf[i];
        }
        if (calculated_checksum != received_checksum) {
            CONSOLE_ERROR("CC1312::BootloaderReceiveBuffer", "Checksum mismatch, expected 0x%x but got 0x%x.",
                          received_checksum, calculated_checksum);
            read_success = false;
        }
    }
    uint8_t ack_nack_byte = read_success ? ProtocolByte::kProtocolByteAck : ProtocolByte::kProtocolByteNack;
    SPIWriteBlocking(&ack_nack_byte, 1, true);  // Send ACK or NACK back to the CC1312, then end the transaction.
    if (!read_success) {
        return false;
    }

    // Copy the buffer to the output buffer.
    if (buf_len_bytes < rx_len_bytes - 2) {
        CONSOLE_ERROR("CC1312::BootloaderReceiveBuffer", "Buffer too small, expected %d bytes but got %d.",
                      buf_len_bytes, rx_len_bytes - 2);
        return false;
    }
    memcpy(buf, rx_buf + 2, rx_len_bytes - 2);  // Copy the buffer to the output buffer.
    return true;
}

bool CC1312::BootloaderSendBuffer(uint8_t* buf, uint16_t buf_len_bytes) {
    // Prepare the buffer to send.
    // Send packet size is (buf_len_bytes + size Byte + checksum Byte).
    uint8_t tx_len_bytes = buf_len_bytes + 2;
    uint8_t checksum = 0;
    for (uint16_t i = 0; i < buf_len_bytes; i++) {
        checksum += buf[i];
    }
    uint8_t tx_buf[tx_len_bytes] = {0};
    tx_buf[0] = tx_len_bytes;
    tx_buf[1] = checksum;
    memcpy(tx_buf + 2, buf, buf_len_bytes);
    uint32_t start_time_ms = get_time_since_boot_ms();

    // Cheeky LED update.
    led_flasher_.Update();

    // Send the buffer.
    int16_t bytes_written =
        SPIWriteBlocking(tx_buf, tx_len_bytes,
                         false);  // Don't end transaction, keep reading till we get a nonzero response.
    if (bytes_written < 0) {
        SPIEndTransaction();  // End transaction after error.
        CONSOLE_ERROR("CC1312::BootloaderSendBuffer",
                      "Failed to send buffer, SPI write read call returned error code 0x%x.", bytes_written);
        return false;
    } else if (bytes_written < tx_len_bytes) {
        SPIEndTransaction();  // End transaction after error.
        CONSOLE_ERROR("CC1312::BootloaderSendBuffer", "Failed to send buffer, only %d bytes written.", bytes_written);
        return false;
    }

    // Wait for a response.
    bool got_response = false;
    uint8_t rx_byte;
    while (!got_response) {
        if (get_time_since_boot_ms() - start_time_ms > kSPITransactionTimeoutMs) {
            SPIEndTransaction();  // End transaction after error.
            CONSOLE_ERROR("CC1312::BootloaderSendBuffer", "Timed out waiting for response from CC1312.");
            return false;
        }

        rx_byte = 0;
        int16_t bytes_read = SPIReadBlocking(&rx_byte, 1, false);
        if (bytes_read < 0) {
            SPIEndTransaction();  // End transaction after error.
            CONSOLE_ERROR("CC1312::BootloaderSendBuffer",
                          "Failed to read response, SPI write read call returned error code 0x%x.", bytes_read);
            return false;
        } else if (bytes_read != 1) {
            SPIEndTransaction();  // End transaction after error.
            CONSOLE_ERROR("CC1312::BootloaderSendBuffer", "Failed to read response, only %d Bytes read.", bytes_read);
            return false;
        } else if (rx_byte != 0) {
            got_response = true;
            SPIEndTransaction();  // End the transaction after receiving a response.
        }
    }

    // Interpret the response.
    if (rx_byte == ProtocolByte::kProtocolByteNack) {
        CONSOLE_ERROR("CC1312::BootloaderSendBuffer", "Received NACK from CC1312.");
        return false;
    } else if (rx_byte != kProtocolByteAck) {
        CONSOLE_ERROR("CC1312::BootloaderSendBuffer", "Received unknown response from CC1312: 0x%x.", rx_byte);
        return false;
    }
    return true;
}

bool CC1312::BootloaderSendBufferCheckSuccess(uint8_t* buf, uint16_t buf_len_bytes) {
    if (!BootloaderSendBuffer(buf, buf_len_bytes)) {
        CONSOLE_ERROR("CC1312::BootloaderSendBufferCheckSuccess", "Failed to send command.");
        return false;
    }
    if (BootloaderCommandGetStatus() != kCmdRetSuccess) {
        CONSOLE_ERROR("CC1312::BootloaderSendBufferCheckSuccess", "Command was sent but was unsuccessful.");
        return false;
    }
    return true;
}

bool CC1312::Flash() {
    CONSOLE_PRINTF("CC1312::Flash: Entering bootloader.\r\n");
    // Set up LED flasher for pretty blinks.
    led_flasher_.SetFlashPattern(0b101010000000, 12, 50);  // Triple flash.
    if (!EnterBootloader()) {
        CONSOLE_ERROR("CC1312::Flash", "Failed to enter bootloader mode.");
        return false;
    }

    // Erase the chip.
    CONSOLE_PRINTF("CC1312::Flash: Beginning flash erase.\r\n");
    if (!BootloaderCommandBankErase()) {
        CONSOLE_ERROR("CC1312::Flash", "Failed to erase the chip.");
        return false;
    }
    CONSOLE_PRINTF("CC1312::Flash: Flash erase complete.\r\n");
    // Re-write the CCFG configuration.
    CONSOLE_PRINTF("CC1312::Flash: Writing CCFG configuration.\r\n");
    if (!BootloaderWriteCCFGConfig(config_.ccfg_config)) {
        CONSOLE_ERROR("CC1312::Flash", "Failed to write CCFG configuration.");
        return false;
    }
    CONSOLE_PRINTF("CC1312::Flash: Verifying CCFG configuration.\r\n");
    BootloaderCCFGConfig ccfg_config;
    if (!BootloaderReadCCFGConfig(ccfg_config)) {
        CONSOLE_ERROR("CC1312::Flash", "Failed to read CCFG configuration.");
        return false;
    }
    char ccfg_config_str[256];
    ccfg_config.print_to_buffer(ccfg_config_str, sizeof(ccfg_config_str));
    CONSOLE_PRINTF("CC1312::Flash: CCFG configuration read:\r\n%s", ccfg_config_str);
    if (ccfg_config != config_.ccfg_config) {
        char expected_ccfg_config_str[256];
        config_.ccfg_config.print_to_buffer(expected_ccfg_config_str, sizeof(expected_ccfg_config_str));
        CONSOLE_ERROR("CC1312::Flash",
                      "CCFG configuration does not match expected values after writing. Expected:\r\n%s, "
                      "Got:\r\n%s",
                      expected_ccfg_config_str, ccfg_config_str);
        return false;
    }
    CONSOLE_PRINTF("CC1312::Flash: CCFG configuration written and verified successfully.\r\n");

    CONSOLE_PRINTF("CC1312::Flash: Beginning flash programming. Application is %d Bytes\r\n", sub_ghz_radio_bin_size);

    // Send the download command.
    if (!BootloaderCommandDownload(kBaseAddrFlashMem, sub_ghz_radio_bin_size)) {
        CONSOLE_ERROR("CC1312::Flash", "Failed to send download command.");
        return false;
    }
    CONSOLE_PRINTF("CC1312::Flash: Download command sent successfully.\r\n");

    // Send the application binary data.
    uint32_t flash_offset = 0;
    uint32_t num_chunks = sub_ghz_radio_bin_size / kBootloaderCommandSendDataMaxLenBytes +
                          (sub_ghz_radio_bin_size % kBootloaderCommandSendDataMaxLenBytes != 0 ? 1 : 0);
    uint32_t current_chunk = 0;
    while (flash_offset < sub_ghz_radio_bin_size) {
        uint32_t bytes_to_send = MIN(sub_ghz_radio_bin_size - flash_offset, kBootloaderCommandSendDataMaxLenBytes);
        if (!BootloaderCommandSendData(sub_ghz_radio_bin + flash_offset, bytes_to_send)) {
            CONSOLE_ERROR("CC1312::Flash", "Failed to send application data at offset %d.", flash_offset);
            // TODO: Attempt a retry here?
            return false;
        }
        flash_offset += bytes_to_send;
        current_chunk++;
        CONSOLE_PRINTF("CC1312::Flash: Sent %d Bytes, total sent: %d Bytes [%d / %d chunks].\r\n", bytes_to_send,
                       flash_offset, current_chunk, num_chunks);
    }
    CONSOLE_PRINTF("CC1312::Flash: Application data sent successfully.\r\n");

    if (!ApplicationIsUpToDate()) {
        CONSOLE_ERROR("CC1312::Flash", "Application is not up to date after flashing.");
        return false;
    }
    CONSOLE_PRINTF("CC1312::Flash: Application is up to date.\r\n");

    if (!ExitBootloader()) {
        CONSOLE_ERROR("CC1312::Flash", "Failed to exit bootloader mode.");
        return false;
    }
    CONSOLE_PRINTF("CC1312::Flash: Exited bootloader mode successfully.\r\n");

    return true;
}

bool CC1312::SPIBeginTransaction() {
    standby_clk_config_ = spi_get_clk();  // Save existing clock config.
    spi_set_clk(active_clk_config_);

    // Don't need to wait for processing time in bootloader, since we wait for acks.
    if (!in_bootloader_) {
        while (get_time_since_boot_us() - spi_last_transmit_timestamp_us_ < spi_handshake_lockout_us_) {
            // Wait for the lockout period to expire before checking the handshake pin.
            // This handshake lockout interval is too short to check for a handshake timeout during.
        }
        while (get_time_since_boot_us() - spi_last_transmit_timestamp_us_ < kSPIPostTransmitLockoutUs) {
            // Wait for the lockout period to expire before starting a new transaction.
            if (expecting_handshake_ && SPIGetHandshakePinLevel()) {
                // If we are expecting a handshake and the pin is high, we can proceed with the transaction.
                break;
            }
        }
    }

    gpio_put(config_.spi_cs_pin, false);

    return true;
}

void CC1312::SPIEndTransaction() {
    spi_set_clk(standby_clk_config_);  // Restore clock config.

    // NOTE: For some reason changing the SPI format here caused a hardfault, intermittently. My best guess is that the
    // SPI format registers didn't like being hammered on every transaction for some reason. Format change has been
    // moved to the EnterBootloader and ExitBootloader functions. This removed the hardfault but means other peripherals
    // on the SPI bus can't be accessed while the CC1312 is simultaneously in bootloader mode.
    // Update: Transitioned all peripherals to use the same SPI polarity and phase as the CC1312 bootloader.

    // Clear after each transaction (like ESP32). Left set, the next SPIBeginTransaction() would end the post-transmit
    // lockout on this reply's still-high HANDSHAKE line, before the CC1312 re-arms SPI, and the request would be lost.
    expecting_handshake_ = false;
    gpio_put(config_.spi_cs_pin, true);
    spi_last_transmit_timestamp_us_ = get_time_since_boot_us();  // Update the last transmit timestamp.
}

int CC1312::SPIWriteReadBlocking(uint8_t* tx_buf, uint8_t* rx_buf, uint16_t len_bytes, bool end_transaction) {
    int bytes_written = 0;

    CPUMonitor::WorkScope work;
    SPIBeginTransaction();

    if (tx_buf == nullptr) {
        // Transmit 0's when reading.
        bytes_written = spi_read_blocking(config_.spi_handle, 0x0, rx_buf, len_bytes);
    } else if (rx_buf == nullptr) {
        bytes_written = spi_write_blocking(config_.spi_handle, tx_buf, len_bytes);
    } else {
        bytes_written = spi_write_read_blocking(config_.spi_handle, tx_buf, rx_buf, len_bytes);
    }

    if (bytes_written < 0) {
        CONSOLE_ERROR("SPICoprocessor::SPIWriteReadBlocking", "SPI write read call returned error code 0x%x.",
                      bytes_written);
    }

    if (end_transaction) {
        SPIEndTransaction();
    }
    return bytes_written;
}
