PantsForBirds/adsbee/firmware/adsbee_1421/ti/lr2021/lr2021.cpp

#include "lr2021.hh"
#include "mlat/mlat_clear_dma.hh"

#include <ti/drivers/dpl/HwiP.h>

#include <cstring>

#include "comms.hh"  // For debug logging.
#include "hal.hh"

// Construction

LR2021::LR2021(LR2021Config config) : config_(config), mode_(ChipMode::kStartup), last_stat_{} {
    SPI_Params_init(&spi_params_);
    // Callback (DMA) mode for every transfer. transferMode is latched at SPI_open, so a single mode must
    // serve both the async RX drain (lr2021_async.cpp) and the ~110 synchronous command call sites; the
    // latter go through the post-and-spin shim in SPITransfer() (lr2021_ll.cpp) and keep their blocking
    // semantics unchanged.
    spi_params_.transferMode = SPI_MODE_CALLBACK;
    spi_params_.transferCallbackFxn = &LR2021::SPICallback;
    spi_params_.mode = SPI_CONTROLLER;
    spi_params_.bitRate = 12'000'000;  // Use max clock rate for CC1314 (12MHz).
    spi_params_.dataSize = 8;
    spi_params_.frameFormat = SPI_POL0_PHA0;
}

// Init

bool LR2021::Init() {
    abort_requested_ = false;
    // Reset the async RX drain: no transfer can be in flight here (DeInit cancels before SPI_close, and
    // a first-ever Init starts from the zero-initialized members).
    drain_state_ = DrainState::kIdle;
    async_done_ = false;
    async_ok_ = false;
    async_in_flight_ = false;
    kept_read_pending_ = false;
    skipped_edge_pending_ = false;
    sync_done_ = false;
    fifo_overflow_pending = false;  // Init reboots the chip below, which clears the FIFO anyway.
    memset(async_tx_buf_, 0, sizeof(async_tx_buf_));  // [2..] must clock zeros during FIFO reads.
    // IRQ chain TX buffers: static contents, pre-packed once so the ISR-side chain never packs bytes.
    // Filled staging slots are deliberately preserved across re-inits -- the thread parses them on its
    // own schedule (e.g. after a sync-sleep wake).
    memset(chain_fifo_tx_buf_, 0, sizeof(chain_fifo_tx_buf_));  // [2..] clocks zeros during the read.
    PackU16(chain_fifo_tx_buf_, kOpcodeReadRxFifo);
    PackU16(chain_clear_tx_buf_, kOpcodeGetAndClearFifoIrqFlags);
    PackU16(chain_irq_tx_buf_, kOpcodeGetAndClearIrq);
    CONSOLE_INFO("LR2021::Init", "Initializing.");
    // Re-enable the IRQ input that DeInit() switched off.
    GPIO_resetConfig(config_.gpio_irq);
    // Hardware reset: hold NRESET (the ENABLE line) low for kResetPulseUs.
    SetEnable(false);
    DelayUs(kResetPulseUs);
    SetEnable(true);
    status_tracker_.Reset();  // No command before the first one after a reset.

    // A SYNC assertion may have tri-stated the interface (and set the abort flag) while we were getting
    // here. Bail before SPI_open re-muxes SCLK/PICO onto the bus the host now owns. A SYNC ISR landing
    // after this check still self-heals: WaitUntilReady below aborts, we SPI_close (pins return to their
    // hi-Z SysConfig defaults), and the main loop re-enters sync sleep which re-tristates.
    if (abort_requested_) {
        return false;
    }

    spi_handle_ = SPI_open(config_.spi_index, &spi_params_);
    if (spi_handle_ == nullptr) {
        CONSOLE_ERROR("LR2021::Init", "SPI_open failed.");
        return false;
    }

    mode_ = ChipMode::kStartup;
    SetEnable(true);
    if (!WaitUntilReady(kBootupTimeoutMs)) {
        CONSOLE_ERROR("LR2021::Init", "Chip failed to become ready after boot.");
        SPI_close(spi_handle_);
        spi_handle_ = nullptr;
        return false;
    }
    mode_ = ChipMode::kStdbyRC;

    // TODO: Set up NTC compensation.

    CONSOLE_INFO("LR2021::Init", "Initialization complete.");
    return true;
}

bool LR2021::DeInit() {
    CONSOLE_INFO("LR2021::DeInit", "De-initializing.");
    SetEnable(false);
    // In reset, DIO6 (LR_IRQ) has a 40 kOhm pull-up that fights the LR_IRQ pull-down (about 0.35 mA at 3.3 V).
    // Turn its input buffer off; Init() restores the SysConfig setting.
    GPIO_setConfig(config_.gpio_irq, GPIO_CFG_NO_DIR);
    if (spi_handle_ != nullptr) {
        // Never close the handle with a DMA in flight: cancel any async drain transfer first (also
        // covers EnterSyncSleep, which reaches here with a drain possibly mid-sequence).
        CancelAsync();
        SPI_close(spi_handle_);
        spi_handle_ = nullptr;
    }
    mode_ = ChipMode::kStartup;
    return true;
}

void LR2021::TristateInterface() {
    // Reconfigure the CC1314-driven pins to high-impedance inputs so an external MCU can drive the
    // shared LR2021 bus during SYNC sleep. Drive ENABLE low first (crisp reset edge instead of an RC
    // decay through the pull-down) so the host takes over a cleanly reset chip; harmless no-op when the
    // pin is already tri-stated. Idle-state internal pulls keep the lines defined during the host
    // handoff: NSS pulled up (CS deasserted), ENABLE/SCLK/PICO pulled down. BUSY/POCI are already inputs
    // and are left untouched. Runs from the SYNC rising-edge ISR (GPIO register writes only), possibly
    // while SPI is still open: GPIO_setConfig un-muxes SCLK/PICO from the SPI peripheral, and the later
    // SPI_close leaves them hi-Z (their SysConfig not-in-use configs are inputs).
    SetEnable(false);
    GPIO_setConfig(config_.gpio_nss, GPIO_CFG_INPUT_INTERNAL | GPIO_CFG_IN_INT_NONE | GPIO_CFG_PULL_UP_INTERNAL);
    GPIO_setConfig(config_.gpio_enable, GPIO_CFG_INPUT_INTERNAL | GPIO_CFG_IN_INT_NONE | GPIO_CFG_PULL_DOWN_INTERNAL);
    GPIO_setConfig(config_.gpio_sclk, GPIO_CFG_INPUT_INTERNAL | GPIO_CFG_IN_INT_NONE | GPIO_CFG_PULL_DOWN_INTERNAL);
    GPIO_setConfig(config_.gpio_pico, GPIO_CFG_INPUT_INTERNAL | GPIO_CFG_IN_INT_NONE | GPIO_CFG_PULL_DOWN_INTERNAL);
}

void LR2021::RestoreInterface() {
    // Take the bus: NSS driven high (deselected), NRESET driven low (Init() releases it). The SysConfig defaults
    // are inputs so the bus is released from boot. SCLK/PICO are muxed to SPI by SPI_open() in Init().
    GPIO_setConfig(config_.gpio_nss, GPIO_CFG_OUTPUT_INTERNAL | GPIO_CFG_OUT_STR_MED | GPIO_CFG_OUT_HIGH);
    GPIO_setConfig(config_.gpio_enable, GPIO_CFG_OUTPUT_INTERNAL | GPIO_CFG_OUT_STR_MED | GPIO_CFG_OUT_LOW);
}

// Private helpers

bool LR2021::WaitUntilReady(uint32_t timeout_ms) {
    // Silent bail-out when the SYNC ISR has handed the bus to an external host: BUSY now reflects the
    // host's traffic, and every command sequence must unwind without issuing further transactions. No
    // CONSOLE_ERROR here -- the abort is expected and this runs once per remaining command in the chain.
    if (abort_requested_) {
        return false;
    }
    uint32_t wait_start_time_ms = get_time_since_boot_ms();
    while (IsBusy()) {
        if (abort_requested_) {
            return false;
        }
        // Wait for the chip to finish its internal power-up and calibration sequence.
        if (get_time_since_boot_ms() - wait_start_time_ms > timeout_ms) {
            CONSOLE_ERROR("LR2021::WaitUntilReady", "Timed out after %u ms.", timeout_ms);
            return false;
        }
    }
    return true;
}

bool LR2021::AcquireBus() {
    // Every synchronous command reaches here (BusLock, or BeginTransaction for a frame outside one). A drain or chain
    // mid-sequence is advanced to idle or a terminal state first: in-flight DMA completes in microseconds and every
    // BUSY wait has its own timeout, so this waits for the tail of one sequence at most (~sub-millisecond). The claim
    // itself runs with interrupts off, so no LR_IRQ edge can start a chain between the check and the claim.
    while (true) {
        if (abort_requested_) {
            return false;
        }
        uintptr_t key = HwiP_disable();
        bool acquired = sync_bus_.TryAcquire(drain_state_);
        if (acquired) {
            // A loop-drain FIFO read can leave the BUSY-fall interrupt armed to arm the uDMA clear: that fall could
            // come between this command's request and response frames. UpdateLR2021 arms the clear again.
            mlat_arm_on_busy_fall_ = false;
        }
        HwiP_restore(key);
        if (acquired) {
            return true;
        }
        ServiceRxDrain();
    }
}

void LR2021::ReleaseBus() {
    uintptr_t key = HwiP_disable();
    bool released = sync_bus_.Release();
    if (released && sync_popped_fifo_) {
        // The line can stay latched over fewer than kIrqDrainThresholdBytes: no blind chain read. The loop drain
        // sees the line high and runs the clear tail.
        sync_popped_fifo_ = false;
        skipped_edge_pending_ = false;
    }
    HwiP_restore(key);
    if (released) {
        RetrySkippedEdge();  // An edge that came while the bus was held starts its chain now.
    }
}

bool LR2021::BeginTransaction() {
    if (sync_bus_.depth() == 0) {
        if (!AcquireBus()) {
            return false;
        }
        frame_holds_bus_ = true;
    }
    mlat_clear_dma::Disarm();  // The uDMA clear shares the bus; a clear in progress ends with BUSY high.
    // Always verify the chip is idle before asserting NSS.  Per §5.4.1.1 the
    // LR2021 will immediately raise BUSY once it sees the NSS falling edge, so
    // checking BUSY *after* asserting NSS would race with the hardware.
    if (!WaitUntilReady()) {
        EndTransaction();
        return false;
    }
    SetNSS(false);
    return true;
}

void LR2021::EndTransaction() {
    SetNSS(true);
    if (frame_holds_bus_) {
        frame_holds_bus_ = false;
        ReleaseBus();
    }
}

void LR2021::ParseStat(uint16_t raw) {
    // Table 6-38:
    //   [15:12] always 0
    //   [11:9]  CommandStatus
    //   [8]     InterruptStatus
    //   [7:4]   ResetSource
    //   [3]     rfu
    //   [2:0]   ChipMode
    last_stat_.command_status = static_cast<CommandStatus>((raw >> 9) & 0x7);
    last_stat_.interrupt_active = (raw >> 8) & 0x1;
    last_stat_.reset_source = static_cast<uint8_t>((raw >> 4) & 0xF);
    last_stat_.chip_mode = static_cast<ChipMode>(raw & 0x7);
}

void LR2021::DelayUs(uint32_t us) {
    uint64_t start_time = get_time_since_boot_us();
    while (get_time_since_boot_us() - start_time < us) {
        // Busy wait.
    }
}

bool LR2021::SetOokADSB(SettingsManager::R1090PreambleMode preamble_mode, uint8_t agc_gain, uint8_t rx_boost) {
    const bool df17_mode = IsOokDF17PreambleMode(preamble_mode);
    // The caller (ADSBee::ApplyReceiverConfig) guarantees the chip is in a clean kStdbyRC state via
    // a fresh Init() before this runs, so the config commands below execute from standby.
    if (!SetRfFrequency(1090e6)) {
        return SequenceStepFailed("LR2021::SetOokADSB", "SetRfFrequency");
    }
    if (rx_boost > RxBoost::kBoostMax) {
        rx_boost = RxBoost::kBoostMax;
    }
    if (!SetRxPathAdv(RxPath::kLfPath, static_cast<RxBoost>(rx_boost))) {
        return SequenceStepFailed("LR2021::SetOokADSB", "SetRxPathAdv");
    }
    // Calibrate the RF frontend on the LF path at 1090MHz (currently selected RF frequency).
    if (!CalibFe()) {
        return SequenceStepFailed("LR2021::SetOokADSB", "CalibFe");
    }
    if (!SetPacketType(PacketType::kPktOok)) {
        return SequenceStepFailed("LR2021::SetOokADSB", "SetPacketType");
    }
    if (!SetOokModulationParams(2e6,                                // 2Mbps bitrate
                                OokPulseShape::kOokPulseShapeNone,  // No pulse shaping
                                OokRxBw::kOokRxBw3076kHz            // 3.076MHz Rx bandwidth

                                )) {
        return SequenceStepFailed("LR2021::SetOokADSB", "SetOokModulationParams");
    }
    // Every mode runs with the hardware CRC off and checks the CRC in software. The FIFO packet is 14 bytes of raw
    // bits (GetOokRxPacketLenBytes).
    if (!SetOokPacketParams(8,                                     // Tx preamble length
                            kOokAddrCompOff,                       // No address filtering
                            kOokPktFormatFixedLength,              // Fixed length packets
                            GetOokRxPacketLenBytes(preamble_mode),  // Payload length (mode dependent)
                            kOokCrcOff,                            // No hardware CRC
                            kOokEncodingManchesterInv              // Inverted Manchester encoding
                            )) {
        return SequenceStepFailed("LR2021::SetOokADSB", "SetOokPacketParams");
    }
    // CRC handling. Bit 0x01000000 of 0xF30844 must be CLEARED for Mode S reception. Empirically,
    // setting it breaks reception entirely (it was the old AT+R1090_LR_CRC=1 path): the OOK engine
    // stops delivering discrete fixed-length packets and instead dumps a mangled variable-length
    // stream to the FIFO. With the bit cleared, the engine delivers clean fixed-length packets
    // (11-byte payload + the appended 24-bit Mode S parity = 14 bytes; GetOokRxPacketLenBytes) that
    // the software CRC validates. The 24-bit CRC is already present in the FIFO in this state, so no
    // "append CRC" toggle is needed. We always clear it.
    // https://github.com/TheClams/lr2021/blob/f3a26eed0aebc10f068d4d03a3c133bc97ecdc29/src/radio.rs#L254
    // NOTE(hardware-validate): register 0xF30844 is undocumented; its exact meaning is unconfirmed,
    // but bench testing shows clear = working reception, set = no valid packets.
    if (!WriteRegMemMask32(0xF30844, 0x01000000, 0)) {
        return SequenceStepFailed("LR2021::SetOokADSB", "WriteRegMemMask32");
    }

    // No sync word in either mode: preamble mode uses the preamble detector; DF17 mode puts the
    // DF=17 data bits directly in the detector pattern.
    if (!SetOokSyncWord(0, kOokBitOrderLsbFirst, 0)) {
        return SequenceStepFailed("LR2021::SetOokADSB", "SetOokSyncWord");
    }
#ifdef HARDWARE_UNIT_TESTS
    // Pattern length override so a target test can make the chip reject a config.
    uint8_t test_len_chips = 0;
    if (test_detector_len_override_count > 0) {
        test_detector_len_override_count--;
        test_len_chips = test_detector_len_override;
    }
#else
    const uint8_t test_len_chips = 0;
#endif
    if (df17_mode) {
        // Detect on the preamble tail + leading DF=17 data bits (see lr2021_ook_adsb.hh).
        if (!SetOokDetector(kOokDF17Detector.pattern,  // Preamble tail + DF17 header chips
                            (test_len_chips ? test_len_chips : kOokDF17Detector.len_chips) - 1,  // Field is N-1
                            0,                                   // No pattern repetition
                            false,                               // (no sync word used)
                            OokSfdKind::kOokSfdKindFallingEdge,  // SFD on falling edge
                            0                                    // SFD length
                            )) {
            return SequenceStepFailed("LR2021::SetOokADSB", "SetOokDetector");
        }
    } else {
        // MODE_S detects on the whole preamble, so the capture starts at message bit 0.
        const uint16_t pattern = LR2021OokAdsb::kModeSPattern;
        const uint8_t pattern_len_chips = LR2021OokAdsb::kModeSPatternLenChips;
        if (!SetOokDetector(pattern,  // Preamble pattern (LSB-first chips)
                            (test_len_chips ? test_len_chips : pattern_len_chips) - 1,  // Field is N-1
                            0,                                   // No pattern repetition
                            false,                               // Sync word is not raw
                            OokSfdKind::kOokSfdKindFallingEdge,  // Start frame delimiter on falling edge
                            0                                    // Start frame delimiter length
                            )) {
            return SequenceStepFailed("LR2021::SetOokADSB", "SetOokDetector");
        }
    }
    // Set up the FIFO. The high threshold doubles as the IRQ-paced drain valve: kIrqRxFifo latches
    // (and the DIO6 IRQ line rises) only once 11 whole packets have accumulated, i.e. only when the
    // main loop's routine level-read sweep is falling behind. The loop drain does NOT gate on this
    // flag (it reads the level unconditionally), so sub-threshold packets still flow with loop
    // latency.
    static_assert(GetOokRxPacketLenBytes(SettingsManager::kR1090PreambleModeModeS) == kOokFifoPacketLenBytes &&
                      GetOokRxPacketLenBytes(SettingsManager::kR1090PreambleModeDF17) == kOokFifoPacketLenBytes,
                  "IRQ drain threshold math assumes 14-byte FIFO packets in every preamble mode.");
    uint8_t rx_fifo_flags = kFifoIrqFlagFifoHigh | kFifoIrqFlagFifoOverflow;
    uint8_t tx_fifo_flags = 0x0;
    uint16_t rx_fifo_low_threshold = 0;  // Not actually used.
    uint16_t rx_fifo_high_threshold = kIrqDrainThresholdBytes;
    if (!ConfigFifoIrqAdv(rx_fifo_flags, tx_fifo_flags, rx_fifo_high_threshold, 0, rx_fifo_low_threshold, 0)) {
        return SequenceStepFailed("LR2021::SetOokADSB", "ConfigFifoIrqAdv");
    }
    // Route the RX FIFO IRQ to DIO6, which is wired to the CC1314's LR_IRQ pin (rising-edge
    // interrupt; see lr2021_irq_drain.cpp). The IRQ register bit is latched: the drain paths clear it
    // over SPI (ClearFifoIrqFlags then GetAndClearIrq) to drop the line.
    if (!SetDioFunction(DioNum::kDio6, DioFunc::kDioFuncIrq, PullDrive::kPullNone)) {
        return SequenceStepFailed("LR2021::SetOokADSB", "SetDioFunction for the IRQ line");
    }
    if (!SetDioIrqConfig(DioNum::kDio6, HostIrqs::kIrqRxFifo)) {
        return SequenceStepFailed("LR2021::SetOokADSB", "SetDioIrqConfig for the IRQ line");
    }

    // DF17: 0 = AGC, 1..15 manual (13 = max). MODE_S: fixed gain, with the saturation blanking off.
    if (!SetAgcGainManual(df17_mode ? agc_gain : LR2021OokAdsb::ModeSGainStep(agc_gain))) {
        return SequenceStepFailed("LR2021::SetOokADSB", "SetAgcGainManual");
    }
    if (!df17_mode &&
        !WriteRegMemMask32(LR2021OokAdsb::kFrontEndRegAddr, LR2021OokAdsb::kFrontEndModeMask,
                           LR2021OokAdsb::kFrontEndModeNoSaturationBlanking)) {
        return SequenceStepFailed("LR2021::SetOokADSB", "turning off saturation blanking");
    }

    uint32_t rx_timeout = 0xFFFFFF;  // Continuous Rx mode (no timeout).
    if (!SetRxAdv(rx_timeout)) {
        return SequenceStepFailed("LR2021::SetOokADSB", "SetRxAdv");
    }

    // SetRxAdv's own status only arrives with the frame after it: check it.
    if (!CheckLastCommandStatus("LR2021::SetOokADSB")) {
        return false;
    }

    return true;
}

#ifdef HARDWARE_UNIT_TESTS
bool LR2021::StartCwTone(bool use_hf_path, uint32_t freq_hz, int8_t tx_power_dbm) {
#ifndef ADSBEE_DEBUG_BUILD
    // Release builds transmit CW on the HF (2.4 GHz) path only; the LF path folds out below.
    if (!use_hf_path) {
        return false;
    }
#endif
    // Begin from a clean standby state.
    if (!SetStandby(SysStandbyMode::kSysStandbyXosc)) {
        return SequenceStepFailed("LR2021::StartCwTone", "SetStandby");
    }
    // Select a continuous-carrier packet type. The chip otherwise keeps the OOK packet type left over
    // from the ADS-B receiver config (SetOokADSB), and in OOK the modulator gates the carrier off, so
    // the TONE test only leaks the LO (~-40 dBm) and the PA never keys. Generic FSK transmits an
    // unmodulated continuous carrier in TONE test mode.
    if (!SetPacketType(PacketType::kPktFskGeneric)) {
        return SequenceStepFailed("LR2021::StartCwTone", "SetPacketType");
    }
    if (!SetRfFrequency(freq_hz)) {
        return SequenceStepFailed("LR2021::StartCwTone", "SetRfFrequency");
    }

    // Select and configure the requested PA. pa_lf_duty_cycle and pa_lf_slices control the PA's duty
    // cycle and maximum output power for BOTH the LF and HF PAs; their standard values are 6 and 7
    // respectively (DS.LR2021 / Semtech reference set_pa_hf()). The basic SetPaConfig leaves
    // pa_hf_duty_cycle at its firmware default (16).
    const PaSel pa_sel = use_hf_path ? PaSel::kHfPa : PaSel::kLfPa;
    if (!SetPaConfig(pa_sel, PaLfMode::kPaLfFsm, /*pa_lf_duty_cycle=*/6, /*pa_lf_slices=*/7)) {
        return SequenceStepFailed("LR2021::StartCwTone", "SetPaConfig");
    }
    if (!SelPa(pa_sel)) {
        return SequenceStepFailed("LR2021::StartCwTone", "SelPa");
    }
    // tx_power is in 0.5 dB steps. Convert the requested dBm and clamp to the active path's range
    // (LF: -19..44 = -9.5..22 dBm, HF: -39..24 = -19.5..12 dBm).
    int16_t tx_power_half_db = (int16_t)tx_power_dbm * 2;
    const int16_t tx_power_min = use_hf_path ? -39 : -19;
    const int16_t tx_power_max = use_hf_path ? 24 : 44;
    if (tx_power_half_db < tx_power_min) tx_power_half_db = tx_power_min;
    if (tx_power_half_db > tx_power_max) tx_power_half_db = tx_power_max;
    if (!SetTxParams((int8_t)tx_power_half_db, RampTime::kRamp16u)) {
        return SequenceStepFailed("LR2021::StartCwTone", "SetTxParams");
    }

    // Calibrate the frontend on the selected path. CalibFe takes the frequency in 4 MHz steps with the
    // MSb selecting the path (0 = LF, 1 = HF); without it CalibFe() would calibrate the LF path.
    uint16_t calib_word = (uint16_t)(freq_hz / 4000000u);
    if (use_hf_path) {
        calib_word |= 0x8000;
    }
    if (!CalibFe(calib_word)) {
        return SequenceStepFailed("LR2021::StartCwTone", "CalibFe");
    }

    // Key up the continuous tone (unmodulated carrier).
    if (!SetTxTestMode(TxTestMode::kTestTone)) {
        return SequenceStepFailed("LR2021::StartCwTone", "SetTxTestMode");
    }

    // Confirm the tone keyed: the next status frame should report the chip in TX mode (kTx, 0x5).
    if (!CheckLastCommandStatus("LR2021::StartCwTone")) {
        return false;
    }
    CONSOLE_INFO("LR2021::StartCwTone", "post-tone chip_mode=0x%x (kTx=0x5) cmd_status=%s",
                 (unsigned)last_stat_.chip_mode, CommandStatusToString(last_stat_.command_status));
    // The carrier is only actually keyed if the chip entered TX. Report failure otherwise so callers
    // don't treat a silent radio as a live carrier.
    if (last_stat_.chip_mode != ChipMode::kTx) {
        CONSOLE_ERROR("LR2021::StartCwTone", "Tone did not key TX: chip_mode=0x%x (expected kTx=0x5).",
                      (unsigned)last_stat_.chip_mode);
        return false;
    }
    return true;
}

bool LR2021::StopCwTone() {
    // Returning to standby drops the carrier.
    if (!SetStandby(SysStandbyMode::kSysStandbyRc)) {
        return SequenceStepFailed("LR2021::StopCwTone", "SetStandby");
    }
    return true;
}

bool LR2021::StartRssiScan(bool use_hf_path, uint32_t freq_hz) {
    // Reconfigure from a clean hardware reset (-> kStdbyRC), mirroring ADSBee::ApplyReceiverConfig():
    // the LR2021's RF/AGC calibration must be set up from kStdbyRC, and reconfiguring out of
    // continuous RX via SetStandby leaves CalibFe failing with CMD_FAIL (observed on hardware).
    DeInit();  // Safe even if never inited (SPI_close is guarded).
    if (!Init()) {
        CONSOLE_ERROR("LR2021::StartRssiScan", "Error during Init.");
        return false;
    }
    if (!SetRfFrequency(freq_hz)) {
        return SequenceStepFailed("LR2021::StartRssiScan", "SetRfFrequency");
    }
    // Boost off so the reading isn't skewed by the extra front-end gain.
    if (!SetRxPathAdv(use_hf_path ? RxPath::kHfPath : RxPath::kLfPath, RxBoost::kBoostOff)) {
        return SequenceStepFailed("LR2021::StartRssiScan", "SetRxPathAdv");
    }
    // Calibrate the frontend on the currently selected path at the currently set RF frequency, exactly
    // as SetOokADSB does. (Explicit calib words, as used in the StartCwTone TX flow, fail with
    // CMD_FAIL in this RX bring-up.)
    if (!CalibFe()) {
        return SequenceStepFailed("LR2021::StartRssiScan", "CalibFe");
    }
    // The RX chain needs a packet type and modulation config even for a bare RSSI measurement; reuse
    // the known-good OOK config from SetOokADSB, which fixes the RX/RSSI bandwidth at ~3.076 MHz.
    if (!SetPacketType(PacketType::kPktOok)) {
        return SequenceStepFailed("LR2021::StartRssiScan", "SetPacketType");
    }
    if (!SetOokModulationParams(2e6,                                // 2Mbps bitrate
                                OokPulseShape::kOokPulseShapeNone,  // No pulse shaping
                                OokRxBw::kOokRxBw3076kHz            // 3.076MHz Rx bandwidth
                                )) {
        return SequenceStepFailed("LR2021::StartRssiScan", "SetOokModulationParams");
    }
    // Auto AGC so GetRssiInst tracks the input power across its full range.
    if (!SetAgcGainManual(0)) {
        return SequenceStepFailed("LR2021::StartRssiScan", "SetAgcGainManual");
    }
    uint32_t rx_timeout = 0xFFFFFF;  // Continuous Rx mode (no timeout).
    if (!SetRxAdv(rx_timeout)) {
        return SequenceStepFailed("LR2021::StartRssiScan", "SetRxAdv");
    }
    // Check SetRxAdv's status, then verify the chip entered RX so callers don't poll RSSI in standby.
    if (!CheckLastCommandStatus("LR2021::StartRssiScan")) {
        return false;
    }
    if (last_stat_.chip_mode != ChipMode::kRx) {
        CONSOLE_ERROR("LR2021::StartRssiScan", "Chip did not enter RX: chip_mode=0x%x (expected kRx=0x%x).",
                      (unsigned)last_stat_.chip_mode, (unsigned)ChipMode::kRx);
        return false;
    }
    return true;
}
#endif
