PantsForBirds/adsbee/(commit log)

2026-09-21 Fix GNSS baud rate persistence and retry unhealthy init probe (#222)
    Four bugs stacked on top of each other caused the GNSS baud rate setting
    to not persist/take effect correctly:
    1. CommsManager::SetBaudRate() persisted uart_set_baudrate()'s hardware-
    rounded return value instead of the requested baudrate, so e.g. 38400
    got saved as 38399.
    2. GNSSReceiver::Init()/ResumeAfterUartHandover() made a redundant
    SetBaudRate() call after boot-time settings were already applied,
    clobbering the just-loaded user setting back to the u-blox module's
    hardcoded 38400 default.
    3. UbloxMAXM10::GetDefaultBaudrate() ignored the persisted setting
    entirely (unlike GenericGNSSReceiver), and Sy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
    [gnss_receiver.cc, ublox_max_m10.cc]
2026-09-23 Fix squawk code packing in MAVLINK by changing all squawk code storage to decimal, change USB descriptors
    [aircraft_dictionary.cpp, decode_utils.cpp, mavlink_decoder.py, object_dictionary.cpp, test_aircraft_dictionary_mode_s.cc, test_decode_utils.cc, test_reporting_aircraftjson.cc, test_reporting_csbee.cc]
2026-09-23 Gate GNSS_FIX console notify on PROTOCOL_OUT=CONSOLE reporting state
    Unsolicited GNSS_FIX lines were printed to the console regardless of
    AT+PROTOCOL_OUT=CONSOLE,NONE, unlike aircraft data reporting. With a
    live GNSS fix this corrupted in-progress binary console transfers
    (e.g. AT+OTA=WRITE), causing OTA writes to stall/fail. Confirmed with
    a hardware OTA test: GNSS_FIX notifications leaked into the console
    mid-write before this fix, and stopped after.
    Claude-Session: https://claude.ai/code/session_01H6SPvppSCLZEzsjqdw1e2P
    [gnss_receiver.cc]
2026-09-24 Fix settings corruption from un-versioned GNSS field insertion, add Sanitize() crash guard
    Commit e1f28fe7 inserted gnss_enabled/gnss_receiver_type/gnss_notify into
    SettingsManager::Settings without bumping kSettingsVersion (stayed at 14)
    and without a migration step, and disabled the CI version_sync_check job
    that exists specifically to catch this. Because the version tag never
    changed, Load() never migrates an old on-flash blob forward -- it's
    raw-memcpy'd into the new, larger, differently-shaped struct, corrupting
    every field from gnss_enabled onward (subg settings, remote_id, feeds,
    mavlink, rx_position) on every device that had already run the drifted
    firmware.
    Fix: freeze the pre-drif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
    [object_dictionary.cpp, settings.cc, settings.cpp, settings_migration.cpp, test_settings.cc]
2026-09-24 Add altitude, heading, speed, and satellite count to GNSS console status
    Extends the Console page's GNSS device status card (previously just
    enabled/fix valid/lat/lon/UTC time) with altitude, heading, speed, and
    satellite count, formatted with units. Threads the fields already present
    on GNSSFix through RP2040DeviceStatus (SPI-synced to the ESP32) and the
    ESP32's device_status JSON.
    Hardware-verified working on the bench unit.
    Claude-Session: https://claude.ai/code/session_01FxGjx3VvCFuDtfnZYGH5Xa
    [adsbee_server.cpp, esp32.cc]
2026-09-24 Address review feedback on FEED_ENABLE (#200)
    - Reword feeds_enabled comments and AT+FEED_ENABLE help text: feeds may go to
    local devices, not only the internet. Help text now notes that per-feed
    active flags set with AT+FEED are left unchanged.
    - Revert kFirmwareVersionPatch to 1 (0.9.1 not yet released).
    - kSettingsVersion stays at main's value (14); the PR no longer rolls it.
    feeds_enabled is part of the unreleased v14 layout, and MigrateV13ToV14
    leaves it at its default (enabled) so migrated devices keep feeding.
    Document that in the migration and assert it in the migration tests.
    [comms_at.cc, comms_ip.cpp, object_dictionary.cpp, settings_migration.cpp, test_settings.cc]
2026-09-24 Document AT+FEED_ENABLE in the ADSBee 1090 datasheet
    Add an AT+FEED_ENABLE section after AT+FEED (set and query syntax, parameter
    table, default, and behaviour relative to per-feed active flags), modelled on
    the AT+LED_ENABLE entry, plus a 20260924 revision history entry. The exported
    PDF under word/exports is not regenerated.
2026-09-24 Add FEED_ENABLE to the web settings page
    Add a "Network Feeds" toggle to SETTINGS_SCHEMA_1090 next to LED_ENABLE in
    the System group, and include FEED_ENABLE in the AT+SETTINGS?JSON bulk dump
    so the page reads it in the same round trip as the other settings.
2026-09-24 ESP32: one image for ESP32-S3-MINI-1U-N8 (no PSRAM) and -N4R2 (2 MB PSRAM)
    Build the ESP32 firmware embedded in combined.uf2 so that it runs on both ESP32-S3
    modules, and detect PSRAM at runtime instead of at compile time.
    Build config (esp/sdkconfig, partitions):
    - CONFIG_ESPTOOLPY_FLASHSIZE_4MB (was 8MB). partitions_remote_id.csv keeps nvs@0x9000,
    phy_init@0xF000 and factory@0x10000 (3 MB, ends 0x310000) so NVS survives an update
    and the RP2040 flasher's fixed 0x10000 app address still holds. It already fit 4 MB,
    so partitions_remote_id_4mb.csv is folded into it and removed.
    - Fold the sdkconfig.psram overlay into sdkconfig and remove it: CONFIG_SPIRAM (quad,
    80 MHz), SPIRAM_IGNOR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
    [partitions_debug.csv, partitions_remote_id.csv, partitions_remote_id_4mb.csv]
2026-09-24 ESP32: return size_t from HardwareCapabilities heap getters
    heap_caps_get_*_size() returns size_t, and existing log call sites format the
    internal free heap with %u. Returning uint32_t (long unsigned on xtensa) broke
    -Werror=format in comms_ip.cpp safe_send() on the CI toolchain.
    [hardware_capabilities.cpp]
2026-09-24 Fix stack buffer overflow in CSBee CRC host tests (#227)
    The CSBeeUtils tests formatted the expected CRC with
    sprintf(calculated_crc_string, "%X\r\n", ...) into a buffer of
    kCRCMaxNumChars + 1 (5) bytes. The output is up to 4 hex digits + "\r\n" +
    NUL = 7 bytes, so the test overflowed the stack by 2 bytes.
    With GCC 12 on x86_64, calculated_crc_string sits directly before the
    crc_str std::string_view, so the overflowing "\n\0" overwrote the low bytes
    of its size field (6 -> 0x0A = 10). crc_str then ran past its NUL, and
    crc_str.compare() returned 4, failing all four CSBeeUtils tests (8 ctest
    cases incl. host_test_fpu). CI's GCC 13 lays out the stack differently, so
    the same undefined behavio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
    [test_reporting_csbee.cc]
2026-09-25 ci/hil: add multi-receiver HIL bench toolkit (adsbee_hil)
    A small Python package and adsbee-hil CLI for benches with many ADSBee
    receivers of different models plus test transmitters:
    - discover: USB enumeration via sysfs (serial, product, port path, app vs
    BOOTSEL, by-id console); works without a bench file.
    - TOML bench inventory of receivers and transmitters; no serials in code.
    - Per-device flock locks keyed by USB serial; operations on selected
    devices (-d/--model/--tag/--all) run concurrently.
    - Receiver drivers: 1090U (UF2 via AT+BOOT_USB_UF2 with the RPI-RP2 drive
    matched by USB port, OTA via ota_upload.py) and 1421 behind the
    programmer jig (HUPCL cleared, baud whitelist swe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
2026-09-25 ci: select the hardware_test 1090U by USB serial
    test_ota.py gains --serial: the console, the RPI-RP2 drive (matched by USB
    port instead of the first RPI-RP2 mount) and a per-device lock all follow
    from the USB serial number, so a second RP2040 board on the bench (e.g. the
    1421 programmer jig, also 2e8a:000a) can't be flashed by mistake. With -p,
    the drive is also matched by the tty's USB port when it can be resolved.
    The hardware_test job passes --serial $HIL_1090U_SERIAL when the repository
    variable HIL_1090U_SERIAL is set and keeps -p /dev/ttyACM0 otherwise.
    [test_ota.py]
2026-09-25 Fix settings corruption on OTA, GNSS console fixes, bump to 0.9.1-rc5 (#228)
    * Gate GNSS_FIX console notify on PROTOCOL_OUT=CONSOLE reporting state
    * Ignore leftover .venv directory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
    [adsbee_server.cpp, esp32.cc, gnss_receiver.cc, object_dictionary.cpp, settings.cc, settings.cpp, settings_migration.cpp, test_settings.cc]
2026-09-25 Log GNSS fix transitions at INFO level instead of gating on PROTOCOL_OUT
    The GNSS_FIX notification was gated on the console reporting protocol being
    something other than NONE. NONE is the factory default, so AT+GNSS=...,1
    produced no output on a stock unit, and enabling a (typically binary)
    console protocol to get the lines back interleaved text into that stream.
    Log the transitions with CONSOLE_INFO instead: they appear only at
    AT+LOG_LEVEL=INFO, which the OTA tools already lower before a transfer.
    gnss_notify is kept and still selects whether transitions are logged; it no
    longer bypasses the log level. Programmatic consumers use AT+GNSS_FIX? or the
    ESP32 metrics JSON, which already carrie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
    [comms_at.cc, gnss_receiver.cc]
2026-09-25 Fall back to defaults when the settings EEPROM read fails
    Load() returned early on an EEPROM read failure, skipping Sanitize(), so a
    partial read could leave arbitrary bytes in settings for Print() and the
    coprocessors. Reset to defaults in RAM and sanitize before returning. The
    defaults are not persisted: the failure may be a transient I2C error and the
    stored settings may still load on the next boot.
    [settings.cc]
2026-09-25 Extend Settings Sanitize() beyond enum ranges
    In addition to clamping enum fields, Sanitize() now:
    - normalizes every bool to 0/1 by inspecting its storage byte (reading a
    bool that holds another value is undefined behavior),
    - forces NUL termination of every fixed-size char array (hostname, WiFi
    SSIDs and passwords, feed URIs, Remote ID TX IDs),
    - resets a Comms or GNSS UART baud rate of 0 to that UART's default (the USB
    console's 0 is left alone),
    - disables GNSS when it is enabled with receiver type NONE.
    CoreNetworkSettings' CRC is recomputed after a fix-up only if it was valid
    before, so sanitizing never makes an untrustworthy block restorable.
    Adds host tests for each case.
    [settings.cpp, test_settings.cc]
2026-09-25 Lock the live Settings layout to kSettingsVersion at compile time
    v15 exists because fields were inserted into Settings twice without a
    version bump, and check_version_sync.sh cannot detect that. Add
    static_asserts in settings.hh tying kSettingsVersion == 15 to the live
    struct's size (1144 B), alignment, nested struct sizes and key field
    offsets, with instructions to bump the version and add a migration instead
    of editing the numbers. settings.hh is compiled for the host tests, RP2040,
    ESP32-S3 and CC1312, so the lock holds on every target that stores or
    transfers Settings.
    Also assert in settings_migration.cpp that the migration chain ends at
    v15 and that the frozen snapshots keep their si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
2026-09-25 Make the boot-time ESP32 reflash robust to GNSS traffic and report failures
    The GNSS module (GPIO 0/1) and the ESP32 serial flasher (GPIO 16/17) share
    uart0. CommsManager::Init() muxes GPIO 0/1 to uart0 before the boot-time
    ESP32 flash, and the RP2040 combines the RX inputs of all pins selected for a
    UART, so the module's NMEA output reached the flasher and broke the ESP32
    bootloader handshake. ESP32SerialFlasher::Init() now parks every other pin
    muxed to its UART as a pulled-up SIO input, and DeInit() restores them. This
    covers the boot path; the AT+ESP32_FLASH path already suspended GNSS.
    FlashESP32() ignored the results of connect_to_target() and flash_binary()
    and always returned true,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
    [comms_at.cc, esp32_flasher.cc, main.cc, settings.cc]
2026-09-25 Explain the ESP32's wait for settings instead of blocking silently
    When the RP2040 and ESP32 firmware disagree on the Settings layout, the
    RP2040 rejects the ESP32's settings request (length mismatch) and the ESP32
    waited forever in xSemaphoreTake(portMAX_DELAY) with no explanation.
    Continuing without settings isn't safe (defaults would bring up a default
    WiFi AP and start the default feeds), so the ESP32 still waits, but in 10 s
    slices, logging each time the settings size and version it expects and that
    the ESP32 should be reflashed. The RP2040's rejection message now says the
    same.
2026-09-25 Cover the whole rc2 blob in the v14 migration test; fix the v14 comment
    V14ShippedRc2BlobMigrates only checked bytes 0-285 plus one mavlink byte,
    and several values it wrote were also the defaults, so a wrong offset for
    those fields would still pass. It now writes a distinctive value into every
    field of the 1140 B rc2 layout (CoreNetworkSettings with a valid CRC,
    Remote ID TX, all ten feeds, mavlink, RxPosition), checks each after
    migration, and checks that the result needs no sanitizing.
    The v14 snapshot comment said adsbee_1421 releases shipped this layout;
    adsbee_1421 never compiles the common Settings struct (its CC1314 firmware
    has its own settings), so say that instead.
    [test_settings.cc]
2026-09-25 Bump firmware RC versions for the settings and ESP32 flasher fixes
    adsbee_1090 0.9.1-rc5 -> rc6, adsbee_1421 RC 4 -> 5. These changes touch
    common/ and the ESP32 image, and firmware is only reflashed on a version
    mismatch, so units already running rc5 from main need the bump to pick
    them up.
    [object_dictionary.cpp]
2026-09-26 Build AT+TX_CW into Debug firmware only and report the build type
    AT+TX_CW keys up an unmodulated carrier on demand (CC1314 sub-GHz or LR2021
    LRLF/LRHF, up to +22 dBm). It sat under HARDWARE_UNIT_TESTS, which the 1421
    defines for every build, so it shipped in Release images. It is now gated
    by ADSBEE_DEBUG_BUILD, which CMake defines only for Debug builds, together
    with the radio-level CW helpers it uses (SubGHzRadio::Start/StopCWTest,
    LR2021::Start/StopCwTone). In Release the command is absent from the table:
    AT+HELP doesn't list it and it returns an unknown-command error. AT+RX_CW
    (receive only) and AT+TEST are unchanged.
    The RP2040 (ADSBee 1090 family) has no on-demand TX test commands;
    A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
    [comms_at.cc, comms_at.cpp, lr2021.cpp]
2026-09-26 Format squawks the same way in aircraft JSON and CSBee
    Both now print static_cast<unsigned>(squawk % 10000) with %04u, which always
    gives exactly four digits and matches the format's signedness. Also note
    that a malformed UAT squawk field intentionally keeps the previous squawk.
2026-09-26 cw_sweep: require a Debug build and add a README
    - Check AT+DEVICE_INFO? before the sweep and stop with a clear error if the
    device reports a Release build, since AT+TX_CW only exists in Debug builds.
    Older firmware that doesn't report its build type is let through.
    - The docstring now names the firmware that has fractional-MHz AT+TX_CW
    (0.3.11-rc6, Debug).
    - Add a README: how to make a Debug build, the options, and that this is a
    conducted-measurement tool (attenuator or dummy load, never an antenna).
    - Use datetime.now(timezone.utc); utcnow() is deprecated.
    - Explain why the baud probe's stray bytes at wrong rates are harmless.
    [cw_sweep.py]
2026-09-26 mavlink_decoder: zero-pad squawks and document the encoding
    Print the squawk as four digits (0356, not 356) and as ---- when
    ADSB_FLAGS_VALID_SQUAWK is clear. The README explains that the field holds
    the octal digits as a decimal number and that older firmware sent an octal
    value (7700 as 4032) and marked missing squawks as valid.
    [mavlink_decoder.py]
2026-09-26 Docs: Debug-only RF test commands, new USB strings in the HIL tooling
    - firmware/README.md: which commands are Debug-only, how to tell a Debug
    build from AT+DEVICE_INFO?, how to build and flash one, and that AT+TX_CW
    is for conducted measurements only.
    - m1421 and 1090 datasheets: the new Firmware Build line in the
    AT+DEVICE_INFO? example, and for the m1421 that AT+TX_CW needs a Debug
    build. The PDFs in word/exports are not regenerated.
    - ci/hil: all RP2040 ADSBee 1090 variants now enumerate as 'Pants for
    Birds' / 'ADSBee 1090' and the programmer as 'Pants for Birds'. Update the
    usb.py comment, README example and test fixtures. 'ADSBee 1090' is not
    added as a model hint because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
    [test_cli.py, test_usb.py, usb.py]
2026-09-27 Mode S and UAT decoder correctness fixes (DO-260B/C, DO-282B) (#229)
    * Fix DF11 interrogator ID truncation accepting corrupted all-call replies
    The DF=11 CRC syndrome (parity XOR interrogator code) was stored in a
    uint16_t, so any corrupted all-call reply whose 24-bit syndrome only had
    bits 16-23 set was treated as an II=0 reply and marked valid. That raises
    the false-accept rate for noise frames that look like DF=11 by 256x, and
    every accepted DF=11 creates an aircraft in the dictionary.
    Keep the full 24-bit syndrome.
    * Decode ADS-B GNSS height (TYPE 20-22) with the altitude code, not as meters
    The 12-bit altitude subfield of TYPE 20-22 airborne position messages
    carries GNSS height (HA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
    [adsbee.cc, aircraft_dictionary.cpp, cw_sweep.py, decode_utils.cpp, mode_s_packet.cpp, mode_s_packet_decoder.cc]
2026-09-28 1421: document the SYNC bootloader backdoor, one-click bootloader entry in the web console (#232)
    * Docs: document the m1421 SYNC bootloader backdoor (RTS/DTR reflash)
    Add firmware/adsbee_1421/README.md with a canonical "Reflashing over UART:
    the SYNC bootloader backdoor" section: the CCFG settings, pin/wiring and
    RTS/DTR polarity tables, the entry sequence, what the programmer jig does
    (automatic entry, RTS/DTR pass-through, 50 ms DTR-edge reset, baked-image
    recheck), a pyserial example, which tools drive the lines, the SYNC sleep
    and watchdog interactions, prerequisites (0.3.7+, AT+BOOT_UART_BOOTLOADER
    fallback and what it erases) and troubleshooting.
    Link it from the top-level README, f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
    [object_dictionary.cpp]
2026-09-29 Stability, OTA safety, Live Map and ADSBee 1421 Programmer fixes (1090 0.9.1-rc4, 1421 0.3.11-rc4) (#233)
    * ESP32: size UAT uplink in-queue to hold full composite arrays
    The RP2040 packs up to (kMaxLenBytes - header) / sizeof(RawUATUplinkPacket)
    = 3 uplink packets into one CompositeArray write, but the ESP32's
    raw_uat_uplink_packet_in_queue only held 2. Every array with 3 uplinks lost
    the third one in UnpackRawPacketsBufferToQueues(), and a GS3M in range of a
    UAT ground station logged this about once a second:
    ESP32 >> [CompositeArray::UnpackRawPacketsBuffer] UAT Uplink queue full,
    cannot enqueue packet 2 / 3.
    Derive the depth from the composite array size and leave room for two
    array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
    [adsbee_server.cpp, aircraft_dictionary.cpp, bridge.cc, cc1312.cc, comms.cc, comms.cpp, comms_at.cc]
2026-09-30 1421 console: remove the Check bootloader button (#234)
    Check bootloader only ran the ROM bootloader check without entering it.
    Behind the ADSBee 1421 Programmer (or any DTR -> RESET_N adapter), opening
    the port resets the module into its application, so pressing Check alone
    always failed there. Enter bootloader runs the same check after driving
    RTS/DTR, and covers the manual paths too: on an adapter without RTS/DTR
    wired its line changes reach nothing, and with DTR wired its reset lands
    back in the bootloader because SYNC is still held high or
    AT+BOOT_UART_BOOTLOADER erased the vector table.
    - Remove the button, its listener and its UI state handling.
    - Rename checkBootloader() to verifyBo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
2026-09-30 ESP32: recover ~27 kB of internal heap so websockets open with WiFi AP+STA (1090 0.9.1-rc5) (#235)
    * ESP32: add opt-in internal RAM diagnostics (HEAP_DIAGNOSTICS)
    Building with idf.py -DHEAP_DIAGNOSTICS=1 logs, every 10 s at WARNINGS level:
    free internal heap at each boot stage, current free / largest free block /
    minimum ever free, DMA-capable free, and each task's stack high-water mark.
    Normal builds compile the calls to empty inline functions.
    * ESP32: right-size task stacks to free 25 kB of internal RAM
    Task stacks come out of the internal heap. Measured peak use (HEAP_DIAGNOSTICS
    high-water marks on an ADSBee 1090U without PSRAM, WiFi AP+STA, web UI open
    with Live Map and all three w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
2026-10-01 ESP32: cap WiFi dynamic TX buffers at 8 (#240)
    In WiFi AP+STA under load, the internal heap has about 54 kB free in
    steady state, but it briefly drops to a few kB while a page load and the
    feeds are sending. A heap probe showed what fills it: the WiFi driver's
    dynamic TX buffers (~1.6 kB each, up to 16) and dynamic RX buffers
    (~1.7 kB each, up to 16). Together they can take about 53 kB, which is
    all of the headroom, so buffer allocations failed several times per
    10 minutes (19 in a 31 min soak) and dropped frames.
    With 8 TX buffers (13 kB max), the same 12 min AP+STA load had 0 failed
    allocations, against 3 and 7 in two runs with 16. The lowest free heap
    rose from 2.3-6.0 kB to 7.0 kB. Web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
2026-10-01 1090: prefilter single-bit Mode S error correction (#239)
    Adds firmware/common/utils/crc/mode_s_single_bit_filter.hh, a compile-time
    4096-bit bitmap over the low 12 bits of the 112 single-bit CRC-24
    syndromes, ported from the ADSBee 1421 decoder (#236). ModeSPacketDecoder
    checks the syndrome against it before calling
    crc24_find_single_bit_error, so a failed DF=17/18 frame whose syndrome
    can't be a single-bit error skips the 112-entry linear search. Results
    are identical. The decoder already reuses the syndrome computed while
    constructing the packet.
    Host tests in test_mode_s_single_bit_filter.cc check the filter against
    crc24_single_bit_syndrome_112 and compare the filtered search with the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
    [mode_s_packet_decoder.cc, test_mode_s_single_bit_filter.cc]
2026-10-01 Fix ESP32 SPI ack timeouts with Ethernet, unreachable-feed stall and large log pulls (1090 0.9.1-rc5) (#238)
    * ESP32: queue the next SPI receive behind each response to the RP2040
    The RP2040 starts its next transaction 2 ms after it finishes one (kSPIPostTransmitLockoutUs). After sending a
    response, the ESP32 SPI slave was only re-armed once the SPI receive task ran again. With Ethernet on, the W5500 RX
    task (priority 15, no core affinity) and the extra load on core 1 regularly pushed that past 2 ms. The IDF slave
    driver keeps CS frozen while no transaction is queued, so the RP2040's next packet was dropped or cut short
    ("bad checksum" packets on the ESP32), and the RP2040 then waited the f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
    [comms_ip.cpp, comms_wifi.cpp, pico.cpp, spi_coprocessor.cpp, websocket_server.cpp]
2026-10-02 1421: receiver modes (MODE_S, MODE_S_STRONG, DF17) and LR2021 CPU/robustness fixes (#236)
    * 1421: Mode S dynamic range: raise the LR2021 AGC trigger, add MODE_S_STRONG, default to MODE_S_SW_CRC (0.3.11-rc4)
    Bench characterization (Pluto wiggler into the ADSBee 1421 on the CI Pi) showed two
    separate causes for the Mode S losses:
    - The standard preamble modes stop decoding at -50 dBm because the LR2021 AGC cuts the
    gain during the preamble of any packet from about -53 dBm up, and the OOK demodulator
    puts out nothing for about 4.5 us (9 chips) while it settles. The first three
    preamble pulses (chips 0, 2 and 7) never reach the detector.
    - DF17 mode detects on preamble chips 8-15 plus th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
    [adsbee.cpp, comms_at.cpp, lr2021.cpp, lr2021_async.cpp, lr2021_common.cpp, lr2021_fifo.cpp, lr2021_ll.cpp]
2026-10-02 Web settings: read every setting from one AT+SETTINGS?JSON dump (1090 0.9.1-rc5) (#245)
    * Web settings: read every setting from one AT+SETTINGS?JSON dump
    The settings page already tried AT+SETTINGS?JSON first, but any failure of
    that one read (a timeout, a line cut short, or a log line printed into the
    middle of it) silently dropped it to querying all 20 settings one at a time.
    Those single queries end on a 350 ms quiet timer and run over the same lossy
    console path, so some of them come back empty and the page shows
    "read failed: No response." on several settings and takes 6 to 15 s.
    The console path drops bytes under load: the RP2040 clears its whole network
    console queue when it overflo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
2026-10-02 1421: restore the receiver after AT+TEST (#243)
    * 1421: restore the receiver config after AT+TEST
    * 1421: report AT+TEST failures as an error
    * Make AT+TEST re-runnable: keep the utest registry after utest_main
    utest_main() freed utest_state.tests and every test name on exit without
    clearing them. Static constructors fill that registry once per boot, so a
    second utest_main() call ran the tests from freed memory and freed it
    again. Keep the registry in all three vendored copies (1421 TI, 1090
    RP2040, 1090 ESP32), drop the run-once guards and the run-once note in
    the 1421 AT+TEST help, and report any failed test as an error on the 1090
    too.
    * 1090: pause the watchdog while AT+TEST runs
    Th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
    [adsbee.cpp, comms_at.cpp, hardware_unit_tests.cc, hardware_unit_tests.cpp, utest.h]
2026-10-02 1090: count the MLAT jitter PWM slice at the system clock (#246)
    The MLAT jitter PWM slice was set to a 125/48 divider, but the PWM divider is 8.4 fixed point and the SDK truncates
    it to 41/16 = 2.5625. The slice counted at 48.78 MHz while OnDemodComplete() subtracted its counts from the 48 MHz
    MLAT timestamp, so every Mode S timestamp was off by 1.6% of its jitter correction (about 100-170 ns typical, up to
    about 460 ns, varying with ISR latency).
    The slice now counts the system clock, and MLATJitterCountsTo48MHzCounts() converts with the same 48/125 ratio as
    the SysTick scaling in GetMLAT48MHzCounts(). The 16-bit counter wraps every 524 us; corrections stay under 30 us.
    The wrap case of t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
    [adsbee.cc, test_clocks.cc]
2026-10-02 1421: replace AT+BOOT_UART_BOOTLOADER with AT+BOOTLOADER_PIN; Programmer pass-through fallback (#242)
    * 1421: replace AT+BOOT_UART_BOOTLOADER with AT+BOOTLOADER_PIN (CCFG backdoor enable/disable)
    AT+BOOT_UART_BOOTLOADER erased flash sector 0 to force the ROM into its
    serial bootloader. Remove it, ADSBee::EnterUARTBootloader() and their docs.
    AT+BOOTLOADER_PIN=<0|1>[,DRYRUN] turns the SYNC (DIO_5) bootloader backdoor
    off or on in the CCFG BL_CONFIG word, and AT+BOOTLOADER_PIN? reports the
    live CCFG value. On the CC13x4 the CCFG is its own 2 KB flash sector at
    0x50000000 holding only the CCFG struct. Disabling only clears bits
    (BL_ENABLE 0xC5 -> 0x00) and programs that word in place. Enablin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
    [adsbee.cpp, comms_at.cpp, main.cpp, status.cc, test_cdc_text.cc]
2026-10-02 Add versioned MkDocs docs site (wiki) migrated from the GitHub wiki and pantsforbirds.com (#248)
    * docs: migrate the GitHub wiki and the pantsforbirds.com ADSBee pages to Markdown
    Pages under docs/, converted from the published versions:
    - index.md: ADSBee overview from pantsforbirds.com/adsbee/ plus the wiki home page
    - getting-started/quick-start.md: pantsforbirds.com/adsbee/quick-start/
    - adsbee-1090/index.md, adsbee-1421/index.md: the family tabs of pantsforbirds.com/adsbee/
    - adsbee-1090/winglet.md: pantsforbirds.com/adsbee/winglet/
    - adsbee-1421/m1421.md: pantsforbirds.com/adsbee/dual-band-module/
    - guides/update-firmware.md, guides/modify-enclosure.md: the two wiki pages, merged with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
2026-10-02 1090 hardware unit tests: read the MLAT counter on core 1, skip self-verify on the combined image, median CPR timing (#247)
    the 1421 AT+TEST help, and report any failed test as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
    [hardware_unit_tests.cc, test_aircraft_dictionary.cc, test_clocks.cc, test_flash.cc]
2026-10-02 1421: reach STANDBY during SYNC sleep (LED clock, watchdog wake, floating inputs) (#241)
    * 1421: wake from SYNC sleep to feed the watchdog
    The CC13x4 watchdog keeps counting in STANDBY, and with no ClockP event
    pending the power policy can stay in STANDBY until SYNC drops. A
    watchdog reset while SYNC is high starts the ROM bootloader, which runs
    at active current and doesn't return to the application when SYNC drops.
    EnterSyncSleep() now runs a periodic ClockP at half the configured
    watchdog timeout (500 ms if the watchdog was started and then set to 0)
    so the sleep loop wakes and feeds it. Each wake costs well under 1 ms of
    active time.
    Today the LED clock wakes the MCU every 100 us duri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
    [adsbee.cpp, comms_at.cpp, led.cpp, lr2021.cpp, main.cpp]
2026-10-03 MAVLink HEARTBEAT version 3; ADSBee 1421 Programmer follows the console baud rate (#244)
    * MAVLink: send HEARTBEAT with mavlink_version 3 and keep a 1 Hz reporting round
    The HEARTBEAT sent by ReportMAVLINK carried the framing version (1 or 2) in
    mavlink_version. The MAVLink spec fixes that field at 3 for both framings, and
    mavlink_msg_heartbeat_send_struct sends the struct bytes as they are, so both the
    ADSBee 1090 and the ADSBee 1421 sent a malformed HEARTBEAT. The heartbeat is now
    built by MAVLINKHeartbeatMessage() in mavlink_utils, with host tests that check its
    fields and compare the MAVLink 1 and MAVLink 2 frames against frames packed by
    pymavlink.
    The locally decoded reporting round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
    [at_client.cc, autobaud.cc, bridge.cc, comms.cpp, comms_at.cpp, console_lock.cc, edge_capture.cc]
2026-10-03 Trim verbose comments and docs; add brevity guidance to AGENTS.md (#250)
    * AGENTS.md: add comment and docs brevity guidance
    * AGENTS.md: trim version and SYNC sleep notes
    * ADSBee 1421 Programmer: trim verbose comments and README
    * 1421: trim verbose comments and README
    * common: trim verbose comments
    * 1090: trim verbose comments and ESP32 README
    * CI, scripts, docs and consoles: trim verbose comments and READMEs
    * Trim verbose comments in files shared with open PRs
2026-10-03 1090: send heartbeats with no packet traffic (#252)
    * 1090: send MAVLink/GDL90 heartbeats with no packet traffic (0.9.1-rc6)
    The RP2040 and the ESP32 feed task only ran locally decoded reporting when
    raw packets arrived, so with no traffic no heartbeats went out.
    * 1090: keep version 0.9.1-rc5 (the rc5 release and tag were withdrawn)
2026-10-06 Set UAT symbol rate to 1,041,667 Bd on 1421 and 1090 sub-GHz radios (#261)
    rateWord 0xA6BFB gave 1,042,180 Bd (+493 ppm), enough slip to corrupt
    long FIS-B uplink frames. 0xA6AAB gives 1,041,667.2 Bd. Bump adsbee_1421
    to 0.3.11-rc5 and adsbee_1090 to 0.9.1-rc6.
    [object_dictionary.cpp]
2026-10-07 1421: two receiver modes, MODE_S (default) and DF17 (#266)
    * 1421: two receiver modes, MODE_S (fixed gain 13, no saturation blanking, default) and DF17
    MODE_S runs the whole-preamble detector at fixed gain step 13 with the front-end
    saturation blanking off (0xF30150[7:0] = 0x18). MODE_S_STRONG and the AGC-trigger
    MODE_S config are removed. Stored values of removed modes load as MODE_S; a stored
    DF17 stays DF17. No settings version change.
    * m1421 datasheet: MODE_S and DF17 receiver modes, R1090_GAIN AUTO per mode
    * m1421 datasheet: footer firmware version 0.3.10
    * 1421: settings version 5, R1090PreambleMode MODE_S = 0, DF17 = 1; drop the stored-value mapping of removed modes
    Saved setti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
    [adsbee.cpp, comms_at.cpp, lr2021.cpp, test_settings.cc]
2026-10-07 m1421 datasheet: export the PDF for the two-mode receiver (#268)
    * CI: export changed Word docs to PDF with LibreOffice
    * CI: fix docx-export font check
    * CI: docx-export loop note
    * CI: docx-export layout closer to Word
    Pin LibreOffice 26.8.1.1 from TDF, build substitute fonts with Word's line
    metrics (make_fonts.py) and adjust a copy of each docx before export (prep.py).
    * CI: docx-export, Word spacing after multi-column sections, tiny empty footers
    * CI: docx-export, Word-like bullets and 1090 title page fix
    - Courier New from URW Nimbus Mono PS (thin round 'o' bullets, Courier New metrics);
    list bullets use a variant without descent
    - Symbol bullet moved down to SymbolMT's posit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
2026-10-07 CI: export changed Word docs to PDF (#254)
    - Symbol bullet moved down to SymbolMT's position; ascent matched to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
2026-10-07 adsbee_1421: report the bootloader pin in AT+SETTINGS?JSON; console reads it from the dump (#272)
    The web console queried AT+BOOTLOADER_PIN? on its own and waited for an OK that the
    silent-success query never sends, so the Settings tab showed a timeout after 3 s.
    AT+SETTINGS?JSON now carries the live CCFG backdoor state as a read-only BOOTLOADER_PIN
    key, and the console's Bootloader Pin row reads it from the same dump as the other
    settings (also after a write). Firmware whose dump lacks the key shows it as unknown.
2026-10-08 1090: wait quietly for the CC1312 application at boot (0.9.1-rc7) (#274)
    After exiting the CC1312 bootloader, CC1312::Init polled the device status
    with full reads right away. The CC1312 application only starts serving SPI
    about 0.5 s after reset (it blinks its LED first), so the first read used up
    its retries and marked the SPI link down. Every later read then failed fast
    between link probes, and the busy loop printed "Unable to read CC1312 status"
    on each pass: about 2,300 lines per boot.
    Init now sends single quiet read requests every 20 ms until the application
    answers (5 s limit, one error on timeout), then does one full status read.
    CC1312::Update and ADSBee::Update report a lost link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
    [adsbee.cc, cc1312.cc, object_dictionary.cpp]
2026-10-08 1090: pin ESP-IDF image and managed component versions (#276)
    * 1090: pin ESP-IDF image by digest and managed component versions
    CI built the ESP32 firmware with espressif/idf:release-v5.4, a moving branch tag, while
    compose.yml, build.sh and dependencies.lock named v5.5.2. Pin the image that built
    0.9.1-rc6 by digest in compose.yml and build CI through build.sh with it, pin mdns to
    ==1.4.3, record IDF 5.4.4 in dependencies.lock, stop committing managed_components,
    and fail CI when a build changes the lock file. Document how to update the pins.
    Fixes #193
    * 1090: pass git describe to the ESP32 build as PROJECT_VER
    The esp-idf container sees esp/ without .git, so the app descriptor versio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
2026-10-08 1090: reject short WiFi passwords, don't boot loop on a stored one (#279)
    * 1090: reject WiFi passwords WPA2 can't use, don't boot loop on a stored one (#194)
    AT+WIFI_AP and the web UI require 8-63 characters, AT+WIFI_STA also accepts 5 or 13 character WEP keys.
    The ESP32 used to abort in esp_wifi_set_config() on a short AP password and reboot forever; now it logs
    an error and starts only the interfaces with valid settings, keeping Ethernet and SPI up.
    * 1090: skip GDL90 to the WiFi AP when the AP did not start
    [adsbee_server.cpp, comms_at.cc, comms_wifi.cpp]
2026-10-08 Web UI: link a whereplane.xyz feed to this receiver's map (#278)
    * Web UI: link a whereplane.xyz feed to this receiver's map
    The feed editor shows a link to https://globe.whereplane.xyz/?feed=<uuid> for
    Beast feeds to feed.whereplane.xyz. The uuid matches the one the feed sends at
    connect (BuildFeedStartFrame), built from the feed's receiver ID, which
    /api/feed now returns (the standalone console reads it from AT+FEED?).
    Fixes #153
    * Web UI: keep whereplaneMapUrl next to FeedEditor
    [adsbee_server.cpp]
2026-10-09 1090: IPv6 on Ethernet and WiFi station (AT+IP_MODE) (#281)
    * 1090: IPv6 on Ethernet and WiFi station (AT+IP_MODE)
    Adds an IP mode setting for the ESP32's Ethernet and WiFi station
    interfaces: IPV4, DUAL (default) or IPV6. IPv6 uses link-local addresses
    and SLAAC; DNS servers can come from router advertisements (RDNSS).
    IPV6 turns the DHCPv4 client off. The WiFi access point stays IPv4.
    - Settings v16: ip_mode in the tail padding after rx_position (size
    stays 1144). v15 is frozen as settings_v15 and MigrateV15ToV16 keeps
    existing settings, defaulting ip_mode to DUAL.
    - AT+IP_MODE, AT+SETTINGS?DUMP/JSON, web UI settings (IP Mode).
    - AT+NETWORK_INFO shows the IP mode and each interface's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
2026-10-09 Web UI: paste into focused text boxes instead of the console terminal (#277)
    The terminal's document-wide paste handler sent every paste to the console,
    so pasting a feed URL into the feed editor or settings did nothing. The copy
    and paste handlers now skip events aimed at other text boxes (isOtherTextEntry
    in adsbee.js), in the device page and both standalone consoles.
    Fixes #273
2026-10-09 1090: store up to 3 WiFi station networks, join the strongest (#280)
    * 1090: store up to 3 WiFi station networks and join the strongest (#74)
    AT+WIFI_STA_NETWORK=<1-3>,<ssid>,<pwd> stores networks 2-3 (network 1 stays AT+WIFI_STA). With more than
    one st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
    [comms.cpp, comms_at.cc, comms_ip.cpp, comms_wifi.cpp, settings.cpp, settings_migration.cpp, test_settings.cc, test_wifi_network_selector.cc]
2026-10-11 probe: MLAT bench probe (AT+MLAT, DIO_13 edge capture, raw LR2021 commands)
2026-10-11 probe: ISR storm guard, one-shot capture
2026-10-11 probe: recover a latched DIO5 in the capture loop
2026-10-13 probe: capture source select, edge statistics, RX trigger output on DIO_12, counting capture
2026-10-14 Bench counters and frame log (test only, from t0413)
2026-10-14 WIP: uDMA per-packet ClearIrq chain and count pairing (t0421 prototype)
2026-10-14 Fast re-arm of the uDMA clear on BUSY fall after the drain's FIFO read (knob)
2026-10-14 Shorter uDMA clear chain: no GPT1A delay, NSS high before the re-arm tasks
2026-10-14 Shorter chain: NSS high first in the end list; fast re-arm on by default
2026-10-14 Arm the uDMA clear right after a sweep: wait out its last BUSY pulse
2026-10-14 Run a pending clear between the sweep's frames; bench arm-refusal counters
2026-10-14 Pending clear only ahead of a command frame, never between a command and its response
2026-10-25 1090: retry other start offsets when a demodulated frame does not validate (0.9.1-rc12, 1421 0.3.11-rc10)
    A frame that fails its CRC, or an address/parity reply naming no tracked aircraft, is read again at up to 3
    other start offsets (most confident first, within 2 samples, or one chip later after a format without parity)
    and kept only if it validates. Core 0 publishes tracked addresses to core 1 in a Bloom filter. Retries stop
    while 4 or more captures wait. Rescues are counted as offset_retry kinds in corrected_frames.
2026-10-26 1090 lab: weighted chip samples for bit decisions, DF11 fixes that leave an interrogator code, chip-later retry after a CRC fail
    Research branch for t-0876 (stacked on t0872 / #398). Not for merge as is.
    - Bit decisions weigh the 6 samples of each chip (2,3,3,3,3,3 vs 1,3,4,4,4,3, fitted on 385k
    low-confidence bits of live-sky frames) through one 128-byte table, and an even split reads 1.
    Margins are odd, so weak bits fall into 6 levels; weak-bit selection keeps the first 6 bits of
    each level (same order as before: confidence, then position). Offset scoring is unchanged.
    - The CRC guided fix accepts a DF11 left with an interrogator code (<= CL4/IC15); the dictionary
    checks its addre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
2026-10-26 1090 ESP32: Bluetooth controller in ROM, WiFi code in flash, QIO flash (no controller stalls, WiFi at main's level) (#395)
    * 1090 ESP32: Bluetooth controller back in ROM, WiFi IRAM optimizations off (0.9.1-rc11)
    The controller in flash (#353) misses scheduling deadlines on instruction
    cache misses, so scan and advertising stop until the #381 watchdogs reset it.
    The ROM controller doesn't stall but needs ~14 kB more IRAM. Moving the WiFi
    fast-path functions to flash frees ~18 kB IRAM, so free heap stays where it
    was with the controller in flash. Fixes #386.
    * 1090 ESP32: QIO flash mode
    With the WiFi fast paths in flash, DIO flash reads made WiFi feeds and the web
    server slower than main. Q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
2026-10-26 adsbee_swarm: show the enroll token again; a new token keeps the bees (#399)
    * adsbee_swarm: enroll token shown again; a new token keeps the bees (cut off is separate)
    * adsbee_swarm reference UI: eye and copy icons as inline SVG; old-token count links to the bees
2026-10-26 1090 web UI: show the console on first load (no terminal mute) (#401)
    * 1090 web UI: show the console on first load (hide only the update check's AT+DEVICE_INFO? reply)
    The firmware update check muted the terminal for 10 s on page load while it read AT+DEVICE_INFO?
    (the ESP32 sends console output to every /console socket). The welcome banner the receiver sends
    on /console connect landed in that window, so the console stayed blank until Live Map closed and
    reopened the socket. Now only lines that start like the reply are dropped during the check;
    everything else shows at once. Same change in the standalone 1090 console; firmware_release.js
    re-vendored into both consoles.
    Fixes #400
    * 1090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
2026-10-27 1090: retry other start offsets when a demodulated frame does not validate (#398)
    * 1090: retry other start offsets when a demodulated frame does not validate (0.9.1-rc12, 1421 0.3.11-rc10)
    * 1090: skip offset retries while a frame waits for the decoder
    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
2026-10-28 1090: offset retries only for formats with a CRC (fixes #402, 0.9.1-rc13) (#403)
    A retried read is kept only if it passes a CRC (DF11/17/18). An address/parity
    reply (DF0/4/5/16/20/21) is passed on as first read: its parity is the sender's
    address, so a misread landing on a tracked aircraft looked like a good read and
    a clean reply from an untracked aircraft could be reported as a tracked one.
    The tracked-address Bloom filter for core 1 is gone (1 KB RAM). The
    offset_retry_address_parity metric stays and reads 0.
2026-10-29 1090: free 14 kB of RP2040 RAM (#404)
    * 1090: free 20 kB of RP2040 RAM
    - Drop the unused 200-packet raw Mode S queue in ADSBee (6.4 kB).
    - Share one scratch buffer between the raw, Beast, ASTERIX and UAT uplink JSON reports (3.7 kB).
    - Keep the libgcc exception unwinder in flash (3.9 kB of RAM code).
    - Settings migration snapshots on the stack; the v18->v19 step builds the struct in place (2.7 kB).
    - Bit flip log queue sized like the debug log queue (1 kB).
    - ESP32 flash payload buffer in the unused half of scratch Y (1 kB).
    - Release builds leave out the target self-tests (AT+TEST is Debug-only), which registered on the heap at boot.
    - AT+INGEST_MODE_S (Debug) feeds the decoder from core 1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
2026-11-02 1421: AT+SUBG_MODE no longer hangs the module (0.3.11-rc11) (#408)
    SubGHzRadio::SetMode() aborts the RX command and closes the RF client to apply the new sync words. Since
    #310 the RF callback re-posts RX when a command ends with a DONE status, and an aborted command ends with
    PROP_DONE_ABORT, so it re-posted while SetMode() was in RF_close(), which then waited for that command
    forever. The main loop stopped: console silent, the module drawing its normal ~19.8 mA. Clear rx_enabled
    before the abort, as Suspend() does.
    Affects 0.3.11-rc6, rc7 and rc8 (any AT+SUBG_MODE change, including UAT_RX <-> UAT_RX_NO_UPLINK).
    0.3.10 and earlier are not affected. Found on the bench while adding ADS-L (br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
2026-11-03 1090: u-blox config sync skips the keys the GNSS init sets (#413)
    SyncConfigDefaults() wrote 7 of 370 keys back to their factory defaults on every boot, and
    SendInitCommands() then set them again: CFG-ANA-USE_ANA (AssistNow Autonomous off, then on),
    the GSA/GSV/GLL/VTG UART1 outputs, and the MON-RF/NAV-SAT UART1 debug outputs. Comment those
    out of kUbloxConfigDefaults as APP OVERRIDE, with GGA/RMC UART1 (also set by the init, already
    at their defaults). Boot log: "Config sync: wrote 0/361 keys".
    Claude-Session: https://claude.ai/code/session_014Mxqny3RKTLUdzase6NZbK
2026-11-03 1090: automatic updates no longer fail with "flash erase failed" (0.9.1-rc11) (#418)
    Without a /console websocket client the RP2040 sends console output to the
    network only for 10 s after the last network input. The updater erased the
    whole partition (2.7-2.9 MB) with one AT+OTA=ERASE, which takes about 13 s,
    so its OK was never sent and the updater gave up after 30 s. The web updater
    always has a console client and was not affected.
    - ESP32: the updater counts as a console client while it talks to the RP2040.
    - Updater: erases in 256 kB steps, each answering within seconds.
    - Host tests: fake RP2040 with a reply window and erase time; a failed step.
2026-11-04 1421 0.3.11-rc9 + 1090 0.9.1-rc11: fix the 1421 known issues (#420)
    * 1421 0.3.11-rc9 known issues: parity-field fixes, live fix counters, SETTINGS=LOAD applies
    - Address parity correction no longer makes a 2-bit fix with both flips in the
    parity field. Such a reply fits an untracked aircraft a few address bits away
    with one bit error just as well; in the rc8 bench repro nearly every reply
    credited to a tracked aircraft was this case. 1-bit parity fixes (with the
    existing repeat guard) and data+parity fixes are kept. Shared with the ADSBee 1090.
    - ADSBee 1421 AT+RX_STATS? fixed_*/fixes_* include the corrections since the last
    aircraft dictionary update, and RESET clears those too.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
2026-11-04 1421: AT+DEVICE_INFO= no longer fails on a blank module (0.3.11-rc10) (#423)
    The factory station's AT+DEVICE_INFO? loads the 0xFE000 lines into the VIMS flash cache.
    Erase and program don't update the cache, so the read-back check added in 0.3.11-rc1 compared
    against the old (0xFF) bytes and returned ERROR although the write had landed. TI requires the
    cache off during flash writes; FlashUtils::FlashSafe()/FlashUnsafe() now turn it off and back on
    (which also empties it), so device info, settings and CCFG writes all read back from flash.
    The CCFG writer's own copy of that code moved into FlashUtils.
    Also:
    - AT+DEVICE_INFO= stores device_info_version 2; on a blank module it used to copy the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
2026-11-05 1421: AT+LED_ENABLE and AT+LED_BLINK, same syntax as the 1090 (0.3.11-rc11) (#425)
    AT+LED_ENABLE=<enabled> / AT+LED_ENABLE? gate the 1090 and Sub-GHz activity
    LEDs; saved with AT+SETTINGS=SAVE, printed by AT+SETTINGS? and ?DUMP.
    AT+LED_BLINK=<duration_ms>,<led>[,<led>...] lights 1090, SUBG or ALL for
    1-60000 ms, bypassing LED_ENABLE. NETWORK (1090 only) is an error.
    Settings version 7 appends led_enabled; version 5 and 6 blobs migrate with
    LED_ENABLE=1. A downgrade to rc10 (version 6) resets settings to defaults.
    LED flashes no longer cut a longer blink short (later off-time wins).
2026-11-05 ci/hil: Pluto Wiggler / Bee Waggler firmware 2.x command set (T12) (#421)
    * ci/hil: drive Pluto Wiggler / Bee Waggler firmware 2.x with the new command set
    The bee_wiggler transmitter picks the command set from AT+DEVICE_INFO?:
    Bee Wiggler and pwiggd 1.x keep the old commands unchanged; pwiggd 2.x
    uses AT+TX jobs (+DONE, AT+STOP), levels in dBm (same level as 1.x for
    the same bench file), AT+HOLD for dual, AT+SCHED for several explicit
    messages, and opts in to AT+SIMULTANEOUS only for overlapping dual runs
    on a Bee Waggler. pwiggd units use their last CDC-ACM port.
    RELEASE_TESTING names the 2.0 schedule commands.
    * ci/hil: on a 2.x Bee Waggler, jobs go out on both ports (AT+TX=BOTH), as 1.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
2026-11-05 1090: static IPv4 and IPv6 per interface (AT+ETHERNET_IP, AT+WIFI_STA_IP = IPV4,... | IPV6,...) (#426)
    * 1090: static IPv4 on Ethernet and WiFi station (AT+ETHERNET_IP, AT+WIFI_STA_IP)
    - AT+ETHERNET_IP / AT+WIFI_STA_IP = DHCP or <ip>,<netmask>[,<gateway>[,<dns1>[,<dns2>]]].
    Netmask as a dotted quad or prefix length (/1-/30). Checked: unicast, not the subnet's
    network/broadcast address, gateway on the subnet. Not used with IP_MODE IPV6.
    - Settings v20 appends one IPv4Config per interface; v19 frozen, MigrateV19ToV20 keeps all
    settings with DHCP. Migration snapshots v19 in v14/v15's stack space.
    - ESP32: on link up, before the netif's connected handler, the DHCP client is stopped and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
2026-11-06 adsbee_swarm: protocol registry, unknown protocols ignored, listen time, reply protocols (#429)
    * adsbee_swarm: golden test of v1 firmware bodies as stored today
    * adsbee_swarm: protocol registry, unknown protocols ignored and counted, listen_s, frames, reply protocols
    protocols.json is the one server table (ranges.PROTOCOLS/REPORTED/SOURCES/FRAMES and the reference
    UI tabs derive from it; tests check the docs table and openapi against it). An unknown protocol in
    ranges, listen_s or frames is ignored and counted (protocols_ignored, check_protocols) instead of a
    400. listen_s per protocol on SampleRange (migration 0006_listen_time; old rows null; listened-but-
    heard-nothing rows allowed), f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
2026-11-07 1090: one SYNC pulse for the CC1312 and the ESP32; UAT and Remote ID timestamps on the MLAT clock at the source (#428)
    * UAT timestamps on the 48 MHz MLAT clock (sync pulse on the 1090, shared crystal on the 1421)
    UAT packets carried the CC13xx radio timer (32 bits, 4 MHz, at sync word detection) in
    mlat_48mhz_64bit_counts, unconverted, so RAW #UAT* timestamps, Beast UAT frames (12 MHz
    counter = radio timer / 4) and GDL90 uplink TOR were in the wrong units and on the radio
    chip's own clock. Now the receiver converts them to Mode S's 48 MHz MLAT time base before
    ingesting or forwarding (SubGHzTimeSync).
    - 1090: about once a second the RP2040 raises the sync pin (GPIO25 -> CC1312 DIO5) for 1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
2026-11-07 1090: ADSBee Beast extensions (2026-11-06): capabilities check, Remote ID 0xEF, power bytes on every frame (#427)
    * 1090: READSBEE feed protocol and the Remote ID Beast frame 0xEF (readsbee feed spec v2)
    AT+FEED=<i>,...,READSBEE sends what a BEAST feed sends, byte for byte, plus one 0xEF frame per
    received Remote ID packet: 1a EF <b|c|w> ts6=0 dBm(int8, 0x80 = none) MAC6 (display order) and
    the ODID message or pack, bounded per spec section 3. BEAST feeds are unchanged.
    - Settings: kReadsbee appended to ReportingProtocol (uint16, no layout change, no settings
    version). Serial interfaces refuse it (AT+PROTOCOL_OUT) and Sanitize turns a serial READSBEE
    into BEAST.
    - ESP32: IPWANTask hand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
2026-11-07 adsbee_swarm: one Mode S total (frames.mode_s, or older firmware's modes_valid + es_valid) (#432)
    New firmware sends every valid Mode S frame (56- and 112-bit) as frames.mode_s and no
    modes_valid / es_valid. protocols.json: mode_s gets "stats": [] and "legacy_stats":
    ["modes_valid", "es_valid"] (the firmware registry test, #430, compares only "stats").
    - /stats rows gain mode_s = frames.mode_s + modes_valid + es_valid (old rows have only the
    columns, new rows only frames; mixed hours and days add up). Legacy columns stay in the
    rows and the DB; old reports are stored exactly as before.
    - A report with frames.mode_s has modes_valid / es_valid taken as 0 (never counted twice).
    - /range: a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
2026-11-07 Swarm: protocol registry, map slot pool, listen time per protocol, server protocol list (#430)
    * swarm: protocol registry, map slot pool, listen time, reply protocols (WIP)
    * swarm: test fixes, registry vs server protocols.json
    * swarm: listen time from the RP2040's live receiver state
    * esp: keep main's sdkconfig
    * swarm: comment
    * swarm: protocols.json test fails instead of skipping now that it is on main
    * swarm: one Mode S total in frames.mode_s (no modes_valid/es_valid)
    Mode S sends valid 56- plus 112-bit frames as frames.mode_s; the registry entry has no v1 stats
    keys. Without listen time frames.mode_s still goes, as v1 always sent Mode S counts.
    protocols.json from #432 (mode_s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
2026-11-08 1421 docs: AT+LED_ENABLE/AT+LED_BLINK in the m1421 datasheet, 0.4.0-rc1 in m1421.md (#434)
    * 1421 docs: AT+LED_ENABLE/AT+LED_BLINK in the m1421 datasheet, 0.4.0-rc1 in m1421.md
    * word: export PDFs
    word/exports/datasheet_adsbee_m1421.pdf
    ---------
2026-11-09 1090 console: connect by scanning the serial label's QR code (#438)
    Scan (network mode) reads the label QR with the camera, or a photo, and connects to the device's
    default hostname, adsbee1090-YYYMMDDVVXXXX.local, as the firmware derives it from the part code.
    A serial typed, pasted or entered by a barcode scanner converts the same way. BarcodeDetector
    where available, otherwise a vendored jsQR 1.4.0 (Apache-2.0).
2026-11-09 1090 console: Open device page button for browsers that can't reach the device (#439)
    Network mode gets a Device page link (http://<host>/, :port kept, new tab) once a host is
    entered. Where an https page can't open ws:// sockets (Safari and all iPhone/iPad browsers)
    it is yellow and a bar under the tab bar says so. Elsewhere the bar appears after a scan or
    serial conversion and becomes a warning when the connect fails. Connect is unchanged.
2026-11-10 1090 ESP32: read a Beast feed's socket every pass only while its capabilities answer can arrive, then once a second (#440)
2026-11-10 1421: sleep at power-up while SYNC is high without touching the LR2021 bus (0.4.0-rc2) (#442)
    * 1421: boot with the LR2021 bus released and sleep at once while SYNC is high
    * 1421 docs: SYNC at power-up, LR2021 pin states, bootloader backdoor on a shared bus
    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
2026-11-12 1421 + 1090: AT+HELP lists every command whole (1421 0.4.0-rc3) (#444)
    * 1421 + 1090: AT+HELP lists every command whole (1421 0.4.0-rc3)
    1421: the console TX ring frees space only when a UART2_write completes, and one
    write could cover most of the 8 kB ring, so the bounded wait for space (sized for
    the shortfall alone) expired during AT+HELP and dropped whole lines (tx_drops).
    Writes are now at most 256 B and the wait budget includes the write in flight.
    AT+HELP is printed one entry per main loop pass while the ring has room, so the
    listing never blocks reception; console input waits until it is done.
    Both: help strings and long AT replies were cut to the printf buffer (1421: the
    1928 B RX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
2026-11-12 1090 ESP32: keep a cut batch's tail in a buffer of its size instead of closing the feed when there is no backlog memory (#443)
2026-11-13 1090: MLAT sync pulses once a second, latest point + rate on the coprocessors; output overload fix (#436)
    * 1090: sync pulse counts reach the coprocessors before the next pulse's edge
    Under output overload a main loop pass takes ~1.1 s (core 0 waits on the blocking COMMS_UART
    Beast writes while it ingests). SyncPulseService::Update() then recorded pulse N and, with
    kIntervalMs already elapsed, requested pulse N+1 in the same call; core 1 sent N+1 at once and
    only then did esp32.Update() write N's MLAT count. The ESP32 paired that count with N+1's edge
    (one new edge, fresh), the point didn't fit and it re-synced on every pulse, logging a warning
    from its SPI write handler. That held off its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
